danderik88/cbe-ds300-esphome-panel/firmware/images/plan_dark.png

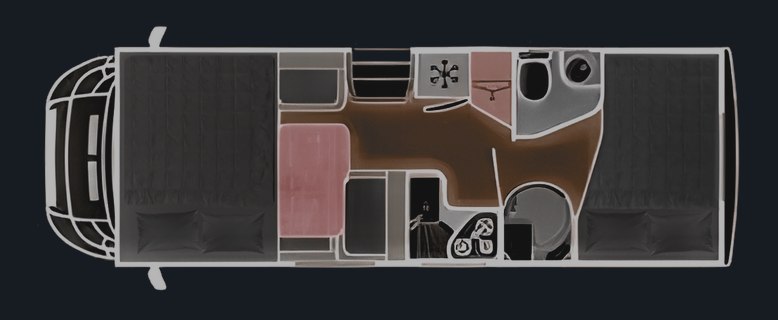
firmware/images/plan_dark.png
