danderik88/cbe-ds300-esphome-panel/firmware/images/plan_light.png

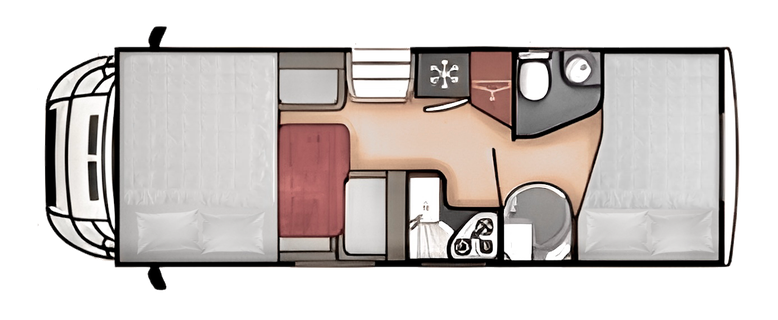
firmware/images/plan_light.png
