danderik88/cbe-ds300-esphome-panel/firmware/images/roof_top_h.png

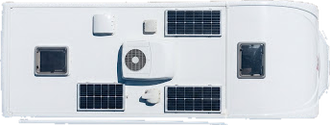
firmware/images/roof_top_h.png
