danderik88/cbe-ds300-esphome-panel/hardware/display-mount/assembly.step

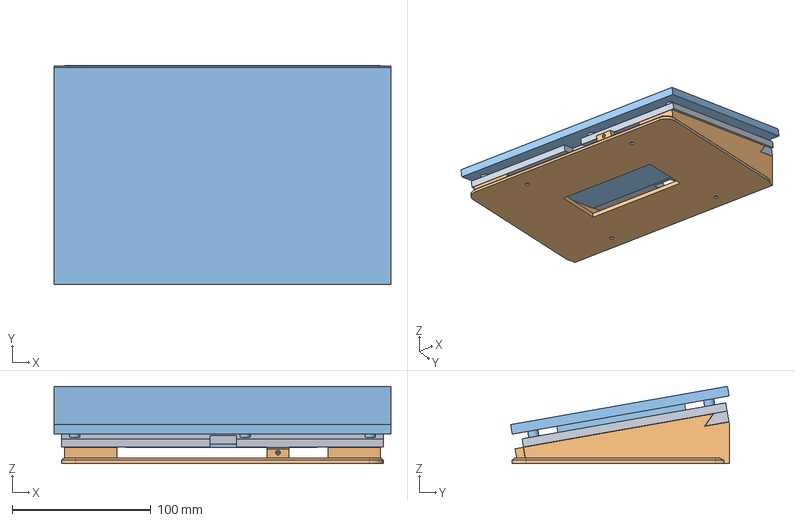
[picture p21: CAD file, 2026-10-14]
hardware/display-mount/assembly.step
242.8 x 157.7 x 55.7 mm
