danderik88/cbe-ds300-esphome-panel/hardware/display-mount/wall_bracket.step

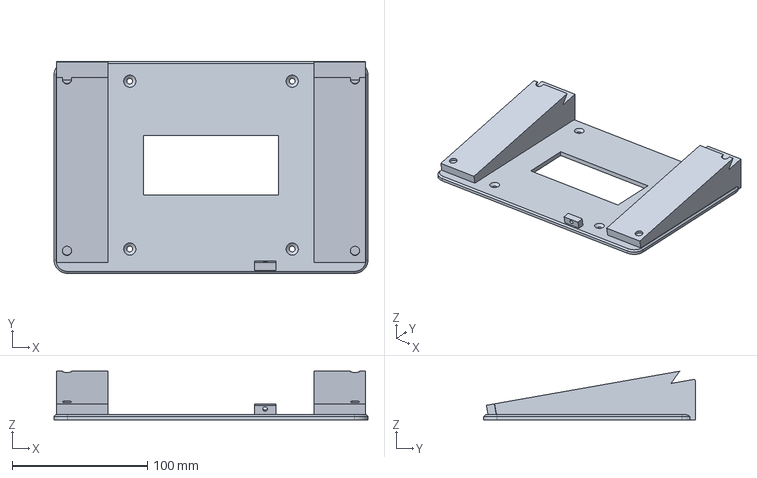
[picture p22: CAD file, 2026-10-14]
hardware/display-mount/wall_bracket.step
232.0 x 156.5 x 35.9 mm
