danderik88/cbe-ds300-esphome-panel/hardware/idc16-plug/idc16_plug.step

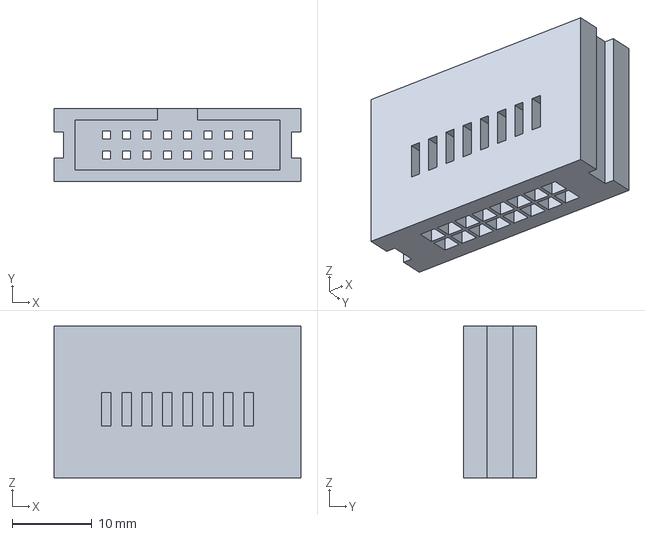
[picture p23: CAD file, 2026-10-14]
hardware/idc16-plug/idc16_plug.step
30.9 x 9.10 x 19.0 mm
