danderik88/cbe-ds300-esphome-panel/hardware/display-mount/display_plate.step

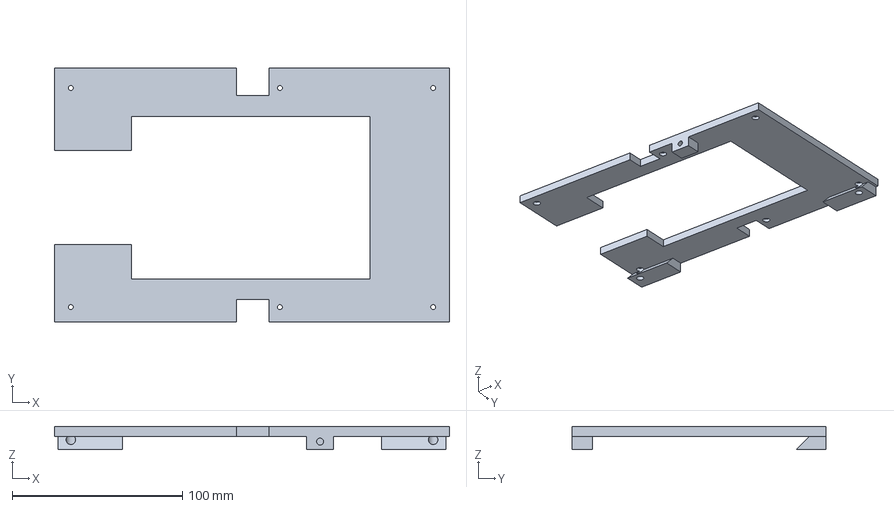
[picture p24: CAD file, 2026-10-14]
hardware/display-mount/display_plate.step
232.0 x 149.0 x 13.8 mm
