danderik88/cbe-ds300-esphome-panel/(list of files, cad)

Other CAD files:
hardware/display-mount/display_plate.stl
hardware/display-mount/wall_bracket.stl
hardware/idc16-plug/idc16_plug.stl
