danderik88/cbe-ds300-esphome-panel/firmware/panel-p4.yaml

## Dashboard camper — Guition JC8012P4A1C (ESP32-P4 + C6, 10.1" 800x1280 MIPI DSI)
##
## UI v2 (docs/ui-v2): camper panel. Fixed navigation bar
## (House, Resources, Climate, Vehicle, Media, System), true Prince layout with
## the 15 lights, autonomy estimates calculated on the panel, vehicle in
## second floor (alarms appear as banners on every page).
## Light/dark theme: switch "Dark Mode" (HA camper_monitor_dark_mode automation).
## WiFi via ESP32-C6 (esp-hosted), HA API. Audio removed (no speakers).
## Flash: see README.md.

substitutions:
  device_name: monitor-camper-p4
  device_friendly: "Monitor Camper"

  # ─── General utilities switch (conn 17 CBE pin 14 = C.GEN) ───
  # PIN required on screen before switching 12V loads.
  utenze_pin: !secret loads_pin

  # ─── CBE NTC probes on ADS1115 ───
  # Measured in camper 2026-09-28: int 12.45k @18.5 C, ext 13.58k @16.5 C.
  # Beta 3950 + R25 9.2k make both within 0.2 C. Beta not verified
  # away from 17 C: a point in water and ice (0 C) confirms it.
  ntc_beta: "3950"
  ntc_r25: "9.2kOhm"
  ntc_r_fixed: "10kOhm"

  # ─── Autonomy estimates ───
  # Ability to convert percentages: 2x100 Ah AGM, 118 L tank.
  batt_ah: "200"
  water_l: "118"
  # Greys: undocumented capacity, ~210 L by eye (2026-10-13). ponytail:
  # the full probe realigns the estimate; correct if the data is discovered.
  grey_l: "210"
  grey_from_fresh: "0.9"
  # Threshold at which battery is considered "empty" (AGM: below 40% triggers
  # critical alert in HA). Water and gas count down to 0.
  batt_floor: "40"

  # Camper Home Assistant (media player album cover)
  ha_url: !secret ha_url

esphome:
  name: ${device_name}
  friendly_name: ${device_friendly}
  min_version: 2026.1.0
  includes:
    - ui_helpers.h
  platformio_options:
    board_build.flash_mode: dio
  on_boot:
    # -100 = after setup complete: at 600 (like on the 7") the P4 crashes at boot
    # because LVGL is not yet initialized when lvgl.page.show starts
    priority: -100
    then:
      - light.turn_on: display_backlight
      - script.execute: apply_theme
      - delay: 1600ms
      - script.execute: { id: nav, idx: 0 }
      - script.execute: update_brightness
      - script.execute: update_utenze
      - script.execute: update_resources
      - script.execute: update_grey
      - script.execute: update_chart


esp32:
  variant: ESP32P4
  flash_size: 16MB
  # NB: 360MHz crashes boot on this chip (rev1.3 + engineering_sample) — see test 2026-07-04
  cpu_frequency: 400MHZ
  engineering_sample: true
  framework:
    type: esp-idf
    advanced:
      enable_idf_experimental_features: true

# WiFi via ESP32-C6 coprocessor (SDIO)
esp32_hosted:
  variant: esp32c6
  reset_pin: GPIO54
  cmd_pin: GPIO19
  clk_pin: GPIO18
  d0_pin: GPIO14
  d1_pin: GPIO15
  d2_pin: GPIO16
  d3_pin: GPIO17
  active_high: true
  sdio_frequency: 20MHz
  # use_psram REMOVED 2026-07-05: build without it stable on bench (6+ min);
  # the reference config (jtenniswood) doesn't use it. The sdio_mempool_create assert
  # on 4/7 it was a symptom of C6 not power-cycled, not the RAM.

psram:
  mode: hex
  speed: 200MHz

# MIPI DSI PHY power supply
esp_ldo:
  - channel: 3
    id: dsi_phy_enable
    voltage: 2.5V
    adjustable: true

# gsl3680 vendorized (kvj/esphome@jd9365_gsl3680 + mark_failed patch for 2026.x)
external_components:
  - source:
      type: local
      path: components
    components: [gsl3680]

logger:
  level: INFO
  # The panel's USB-C uses a UART0 bridge, not USB_SERIAL_JTAG
  hardware_uart: UART0

# Print reset reason + heap on every boot — silent crash diagnostics
debug:
  update_interval: 30s

# ────────────────────────────────────────────────────────────
# Network + Home Assistant
# ────────────────────────────────────────────────────────────
wifi:
  ssid: !secret wifi_ssid
  password: !secret wifi_password
  power_save_mode: NONE
  ap:
    ssid: "${device_name}"
    password: !secret wifi_ap_password

api:
  encryption:
    key: !secret api_key
  # Standalone: never restart if HA is absent (panel useful even without network)
  reboot_timeout: 0s

ota:
  - platform: esphome
    password: !secret ota_password

time:
  - platform: homeassistant
    id: ha_time

# ────────────────────────────────────────────────────────────
# Hardware: I2C, backlight PWM, display MIPI DSI, touch
# ────────────────────────────────────────────────────────────
i2c:
  - id: bus_i2c
    sda: GPIO7
    scl: GPIO8
    frequency: 400kHz
    scan: false
    sda_pullup_enabled: false
    scl_pullup_enabled: false

# External ADC for the two CBE NTC probes: no ADC free on P4
# free (GPIO16-23 and 49-54 are occupied or not wired on the board).
# Breakout on CN4 or FPC3, ADDR to GND -> 0x48. A2/A3 remain free.
ads1115:
  - id: adc_ntc
    i2c_id: bus_i2c
    address: 0x48
    continuous_mode: false

# I2C expander on the same CN4: controls the relay module (hardware/interface-board-bom.md).
# P0 = 1st general utilities relay. Webasto moved to dedicated ESP32 (status via HA).
# At startup outputs are high = relay at rest.
pcf8574:
  - id: exp_out
    i2c_id: bus_i2c
    address: 0x20
    pcf8575: false

# Real PWM backlight (on the 7" it was on/off + software overlay)
output:
  - platform: ledc
    id: backlight_pwm
    pin: GPIO23

light:
  - platform: monochromatic
    output: backlight_pwm
    id: display_backlight
    name: "Retroilluminazione"
    restore_mode: ALWAYS_ON
    default_transition_length: 0s
    gamma_correct: 1.0
# Symmetric wake: anything that turns on the backlight (HA, number
# brightness must also resume LVGL, otherwise screen freezes
    on_turn_on:
      - if:
          condition: lvgl.is_paused
          then:
            - lvgl.resume:
            - lvgl.widget.redraw:

display:
  - platform: mipi_dsi
    id: lcd
    model: JC8012P4A1
    color_order: RGB
    reset_pin: GPIO27
    update_interval: never
    auto_clear_enabled: false
    dimensions:
      width: 800
      height: 1280


# ────────────────────────────────────────────────────────────
# Font: Montserrat from Google Fonts (weights 500/600/700) + MDI.
# Built-in LVGL fonts don't have accented chars, so they're not used.
# ────────────────────────────────────────────────────────────
font:
  - file: "gfonts://Montserrat@700"
    id: f_t11
    size: 11
    bpp: 4
    glyphs: &txt ' !#%&''()*+,-./0123456789:;<=>?@ABCDEFGHIJKLMNOPQRSTUVWXYZ[]_abcdefghijklmnopqrstuvwxyz°·àèéìòù~'
  - file: "gfonts://Montserrat@500"
    id: f_s14
    size: 14
    bpp: 4
    glyphs: *txt
  - file: "gfonts://Montserrat@500"
    id: f_s15
    size: 15
    bpp: 4
    glyphs: *txt
  - file: "gfonts://Montserrat@700"
    id: f_h15
    size: 15
    bpp: 4
    glyphs: *txt
  - file: "gfonts://Montserrat@600"
    id: f_m17
    size: 17
    bpp: 4
    glyphs: *txt
  - file: "gfonts://Montserrat@700"
    id: f_b20
    size: 20
    bpp: 4
    glyphs: *txt
  - file: "gfonts://Montserrat@700"
    id: f_b26
    size: 26
    bpp: 4
    glyphs: *txt
  - file: "gfonts://Montserrat@700"
    id: f_b36
    size: 36
    bpp: 4
    glyphs: *txt
  - file: "gfonts://Montserrat@700"
    id: f_b48
    size: 48
    bpp: 4
    glyphs: *txt
  - file: "gfonts://Montserrat@700"
    id: f_b56
    size: 56
    bpp: 4
    glyphs: *txt
  - file: "gfonts://Montserrat@700"
    id: f_b76
    size: 76
    bpp: 4
    glyphs: "0123456789-,.°"
  # Night screen clock
  - file: "gfonts://Montserrat@700"
    id: f_b200
    size: 200
    bpp: 4
    glyphs: "0123456789:-"
  # Splash
  - file: "gfonts://Montserrat"
    id: mont_76
    size: 76
    bpp: 4
    glyphs: "montercapi"

  # ─── MDI Icons ───
  # Layout (light buttons)
  - file: "fonts/materialdesignicons-webfont.ttf"
    id: i_xs
    size: 20
    bpp: 4
    glyphs:
      - "\U000F17C9"  # wall-sconce-flat-outline (attic)
      - "\U000F179B"  # light-recessed (ceiling lights on bench)
      - "\U000F05BC"  # table-furniture
      - "\U000F0769"  # ceiling-light
      - "\U000F1051"  # led-strip-variant
      - "\U000F1054"  # outdoor-lamp
      - "\U000F04DE"  # stove
      - "\U000F0583"  # walk (hallway)
      - "\U000F09A1"  # shower-head
      - "\U000F09AB"  # toilet
      - "\U000F17D0"  # lamp-outline (nightstands)
      - "\U000F12D3"  # garage-variant (cupboard)
      - "\U000F028F"  # fridge-outline (fridge in the layout)
  # Rows, chips, card headers
  - file: "fonts/materialdesignicons-webfont.ttf"
    id: i_s
    size: 24
    bpp: 4
    glyphs:
      - "\U000F10AF"  # door-closed-lock
      - "\U000F081C"  # door-open
      - "\U000F0647"  # gas-cylinder
      - "\U000F0CC8"  # shield-check-outline
      - "\U000F0026"  # alert
      - "\U000F156D"  # sofa-outline
      - "\U000F0097"  # bunk-bed-outline
      - "\U000F0099"  # bed-outline
      - "\U000F0E50"  # lightbulb-off-outline
      - "\U000F1253"  # lightbulb-group
      - "\U000F0080"  # battery-70
      - "\U000F0084"  # battery-charging
      - "\U000F058C"  # water
      - "\U000F1855"  # water-opacity (greys)
      - "\U000F140B"  # lightning-bolt
      - "\U000F06A5"  # power-plug
      - "\U000F06A6"  # power-plug-off
      - "\U000F07E7"  # power-socket-eu (charging column)
      - "\U000F01FA"  # engine
      - "\U000F0A47"  # engine-off-outline
      - "\U000F1904"  # home-lightning-bolt-outline
      - "\U000F012A"  # chart-line
      - "\U000F0F55"  # home-thermometer-outline
      - "\U000F050F"  # thermometer
      - "\U000F0238"  # fire
      - "\U000F001B"  # air-conditioner
      - "\U000F028F"  # fridge-outline
      - "\U000F058F"  # water-pump
      - "\U000F032A"  # leaf
      - "\U000F14DF"  # rocket-launch-outline
      - "\U000F0717"  # snowflake
      - "\U000F0210"  # fan
      - "\U000F0425"  # power
      - "\U000F0C4D"  # car-tire-alert
      - "\U000F14F1"  # spirit-level
      - "\U000F08F0"  # map-marker-distance
      - "\U000F11BE"  # car-info
      - "\U000F0D5F"  # car-brake-parking
      - "\U000F0B6B"  # car-door
      - "\U000F0C4A"  # car-light-dimmed
      - "\U000F03C7"  # oil
      - "\U000F010C"  # car-battery
      - "\U000F1A80"  # thermometer-water
      - "\U000F0298"  # gas-station
      - "\U000F0469"  # router-wireless
      - "\U000F048B"  # server
      - "\U000F050E"  # theme-light-dark
      - "\U000F05E0"  # check-circle
      - "\U000F0159"  # close-circle
      - "\U000F0028"  # alert-circle
      - "\U000F11D4"  # rv-truck
      - "\U000F051F"  # timer-sand
      - "\U000F07FB"  # van-utility
      - "\U000F075A"  # music
      - "\U000F00DF"  # brightness-6
      - "\U000F0594"  # weather-night
      - "\U000F08A8"  # clipboard-check-outline
  # Navigation bar, scenes, weather, player
  - file: "fonts/materialdesignicons-webfont.ttf"
    id: i_m
    size: 32
    bpp: 4
    glyphs:
      - "\U000F02DE"  # home-variant
      - "\U000F051F"  # timer-sand
      - "\U000F0393"  # thermostat
      - "\U000F07FB"  # van-utility
      - "\U000F075A"  # music
      - "\U000F08BB"  # cog-outline
      - "\U000F0594"  # weather-night
      - "\U000F00DF"  # brightness-6
      - "\U000F059C"  # weather-sunset-up
      - "\U000F0A48"  # exit-run
      - "\U000F0A70"  # silverware-fork-knife
      - "\U000F08A8"  # clipboard-check-outline
      - "\U000F0599"  # weather-sunny
      - "\U000F0595"  # weather-partly-cloudy
      - "\U000F0590"  # weather-cloudy
      - "\U000F0597"  # weather-rainy
      - "\U000F0598"  # weather-snowy
      - "\U000F0591"  # weather-fog
      - "\U000F059D"  # weather-windy
      - "\U000F0593"  # weather-lightning
      - "\U000F0596"  # weather-pouring
      - "\U000F04AD"  # skip-next
      - "\U000F04AE"  # skip-previous
      - "\U000F075D"  # volume-plus
      - "\U000F075E"  # volume-minus
      - "\U000F040A"  # play
      - "\U000F03E4"  # pause
      - "\U000F0425"  # power
      # rest screen
      - "\U000F0F55"  # home-thermometer-outline
      - "\U000F0080"  # battery-70
      - "\U000F0CC8"  # shield-check-outline
      - "\U000F0028"  # alert-circle
  - file: "fonts/materialdesignicons-webfont.ttf"
    id: i_l
    size: 44
    bpp: 4
    glyphs:
      - "\U000F11D4"  # rv-truck (logo)
      - "\U000F051F"  # timer-sand
      - "\U000F01FA"  # engine
      - "\U000F0A47"  # engine-off-outline
      - "\U000F040A"  # play
      - "\U000F03E4"  # pause
      - "\U000F0026"  # alert
      - "\U000F0425"  # power
  - file: "fonts/materialdesignicons-webfont.ttf"
    id: i_xl
    size: 120
    bpp: 4
    glyphs:
      - "\U000F075A"  # music (player cover)

# Prince floor plan (docs/ui-v2/prince-top.png) rotated with the nose to the right and
# already composited on the card colour: one per theme, no runtime filters.
image:
  - file: images/plan_dark.png
    id: img_plan_dark
    type: RGB565
  - file: images/plan_light.png
    id: img_plan_light
    type: RGB565
  - file: images/roof_top_h.png
    id: img_roof
    type: RGB565
    transparency: alpha_channel

touchscreen:
  - platform: gsl3680
    id: touch
    i2c_id: bus_i2c
    reset_pin: GPIO22
    interrupt_pin: GPIO21
    # The GSL3680 sometimes does not raise the touch-release interrupt: without this
    # fallback the touch stays "pressed" and the next tap is swallowed
    # (double tap after a swipe). Forced re-read after 50ms of silence.
    touch_timeout: 50ms
    # Transform for landscape with lvgl rotation: 90 (from espcontrol, same board)
    transform:
      swap_xy: false
      mirror_x: true
      mirror_y: false
    # Touch-to-wake (replaces the touch_any binary_sensor of the 7")
    on_release:
      then:
        - if:
            condition:
              lvgl.is_paused
            then:
              # Turns on at the current brightness (the global may have been
              # changed by the HA automation while the screen was off)
              - light.turn_on:
                  id: display_backlight
                  brightness: !lambda 'return id(display_brightness) / 100.0;'
              - lvgl.resume:
              - lvgl.widget.redraw:
              # Turned off from the clock screen: go back to House
              - if:
                  condition:
                    lambda: 'return id(night_on);'
                  then:
                    - script.execute: night_exit

# ────────────────────────────────────────────────────────────
# ESP32 diagnostics
# ────────────────────────────────────────────────────────────
button:
  - platform: restart
    name: "Riavvia"
    icon: "mdi:restart"

  - platform: safe_mode
    name: "Safe Mode"
    icon: "mdi:shield-bug"

  # Below 10V the DS-300 cuts the loads and only re-arms with OFF->ON
  # of the main switch (CBE manual p. 6).
  - platform: template
    name: "Reset utenze 12V"
    icon: "mdi:restart-alert"
    on_press:
      - switch.turn_off: sw_utenze
      - delay: 3s
      - switch.turn_on: sw_utenze

# ────────────────────────────────────────────────────────────
# Album cover (Media page): HA exposes the media player cover as
# entity_picture (token proxy, no login). The panel downloads it
# from HA on every change and shows it instead of the music note.
# ────────────────────────────────────────────────────────────
http_request:
  timeout: 10s

online_image:
  - id: cover_img
    url: "${ha_url}/local/cover.jpg"  # replaced by set_url, never downloaded on its own
    # Covers from the Apple TV (HomePod) integration arrive as JPEG
    format: JPEG
    type: RGB565
    resize: 400x400
    buffer_size: 32768
    on_download_finished:
      - lvgl.image.update: { id: md_cover, src: cover_img }
      - lvgl.widget.show: md_cover
    on_error:
      - lvgl.widget.hide: md_cover


# ────────────────────────────────────────────────────────────
# ESP32 diagnostics
# ────────────────────────────────────────────────────────────
sensor:
  - platform: wifi_signal
    name: "WiFi Segnale"
    update_interval: 30s
    entity_category: diagnostic

  - platform: uptime
    name: "Uptime"
    entity_category: diagnostic

  - platform: internal_temperature
    name: "Temperatura CPU"
    entity_category: diagnostic
    update_interval: 60s

  # ────────────────────────────────────────────────────────────
  # CBE temperature probes (2-wire NTC) on ADS1115
  # Divider: 3V3 -> fixed R 10k 1% -> ADS channel -> NTC -> GND
  # A0 = INDOOR probe, A1 = OUTDOOR probe
  # ────────────────────────────────────────────────────────────
  - platform: ads1115
    ads1115_id: adc_ntc
    id: ntc_int_v
    multiplexer: A0_GND
    gain: 4.096
    update_interval: 10s
    internal: true
    filters:
      - median:
          window_size: 5
          send_every: 3

  - platform: resistance
    id: ntc_int_r
    sensor: ntc_int_v
    configuration: DOWNSTREAM
    resistor: ${ntc_r_fixed}
    reference_voltage: 3.3V
    internal: true

  - platform: ntc
    id: temp_int_ntc
    sensor: ntc_int_r
    name: "Temp interna (sonda CBE)"
    unit_of_measurement: "°C"
    accuracy_decimals: 1
    calibration:
      b_constant: ${ntc_beta}
      reference_temperature: 25°C
      reference_resistance: ${ntc_r25}
    filters:
      # Probe disconnected / shorted -> absurd value: don't show it
      - filter_out: nan
      - lambda: 'return (x > -40.0f && x < 90.0f) ? x : NAN;'
    on_value:
      - lambda: 'id(ntc_int_seen) = millis();'
      - script.execute: update_temps

  # Grey tank full probe: 3V3 -> 100k -> A2 -> electrode; common = pin 11 (AGND).
  # Dry ~3.3 V, wet below ~1.6 V. The tank only has the full-level pair
  # (blue/brown screws at the top, validated with a jumper 2026-10-13); REC 1/3 (A3)
  # follows the full probe upstream in the DS-300, so it is not read.
  - platform: ads1115
    ads1115_id: adc_ntc
    id: grey_full_v
    name: "Grigie pieno (tensione sonda)"
    multiplexer: A2_GND
    gain: 4.096
    update_interval: 10s
    accuracy_decimals: 2

  - platform: ads1115
    ads1115_id: adc_ntc
    id: ntc_ext_v
    multiplexer: A1_GND
    gain: 4.096
    update_interval: 10s
    internal: true
    filters:
      - median:
          window_size: 5
          send_every: 3

  - platform: resistance
    id: ntc_ext_r
    sensor: ntc_ext_v
    configuration: DOWNSTREAM
    resistor: ${ntc_r_fixed}
    reference_voltage: 3.3V
    internal: true

  - platform: ntc
    id: temp_ext_ntc
    sensor: ntc_ext_r
    name: "Temp esterna (sonda CBE)"
    unit_of_measurement: "°C"
    accuracy_decimals: 1
    calibration:
      b_constant: ${ntc_beta}
      reference_temperature: 25°C
      reference_resistance: ${ntc_r25}
    filters:
      - filter_out: nan
      - lambda: 'return (x > -40.0f && x < 90.0f) ? x : NAN;'
    on_value:
      - lambda: 'id(ntc_ext_seen) = millis();'
      - script.execute: update_temps

  # ─── Energy (Victron SmartShunt) ───
  - platform: homeassistant
    id: ha_batt_soc
    entity_id: sensor.victron_smart_shunt_battery
    on_value:
      - script.execute: update_resources
  - platform: homeassistant
    id: ha_current
    entity_id: sensor.victron_smart_shunt_current
    on_value:
      - script.execute: update_resources
  - platform: homeassistant
    id: ha_batt_v2
    entity_id: sensor.victron_smart_shunt_voltage
    on_value:
      - lvgl.label.update:
          id: rs_batt_u
          text: !lambda 'return ui::fmt(x, 1, " V");'
  - platform: homeassistant
    id: ha_batt_v1
    entity_id: sensor.victron_smart_shunt_starter_battery_voltage
    on_value:
      - lvgl.label.update:
          id: vs_v1
          text: !lambda 'return ui::fmt(x, 1, " V");'
  - platform: homeassistant
    id: ha_batt_power
    entity_id: sensor.victron_smart_shunt_power
    on_value:
      - lvgl.label.update:
          id: rc_pow
          text: !lambda 'return ui::fmt(x, 0, " W");'

  # ─── 230V mains from the hookup post (Sonoff MINI-ZB1GP; unavailable = post unplugged) ───
  - platform: homeassistant
    id: ha_rete_w
    entity_id: sensor.rete_230v_power
    on_value: { script.execute: update_rete }
  - platform: homeassistant
    id: ha_rete_a
    entity_id: sensor.rete_230v_current
    on_value: { script.execute: update_rete }
  - platform: homeassistant
    id: ha_rete_lim
    entity_id: input_number.limite_colonnina
    on_value: { script.execute: update_rete }

  # ─── Water and gas ───
  - platform: homeassistant
    id: ha_water
    entity_id: sensor.esp32_serbatoio_acqua_livello_acqua
    on_value:
      - script.execute: update_resources
      # Greys: count only fresh water drops; hysteresis against level noise
      # (noise counted only on the way down would make the estimate creep up by itself).
      - lambda: |-
          float &ref = id(fresh_ref);
          if (isnan(x)) return;
          if (isnan(ref) || x > ref + 3.0f) { ref = x; return; }  // start or refill
          if (x < ref - 1.0f) {
            id(grey_est_l) = std::min(id(grey_est_l) + (ref - x) / 100.0f * ${water_l} * ${grey_from_fresh}f, (float) ${grey_l});
            ref = x;
            id(update_grey).execute();
          }
  # LPG cylinder by weight (esp32-panca: 4 load cells + HX711)
  - platform: homeassistant
    id: ha_gas_percent
    entity_id: sensor.panca_gas_remaining_percent
    on_value:
      - script.execute: update_resources
  - platform: homeassistant
    id: ha_gas_kg
    entity_id: sensor.panca_gas_remaining
    on_value:
      - lvgl.label.update:
          id: rs_gas_u
          text: !lambda 'return ui::fmt(x, 1, " kg");'

  # ─── Room temperatures ───
  - platform: homeassistant
    id: ha_t_din
    entity_id: sensor.sensore_presenza_dinette_temperature
    on_value:
      - script.execute: update_temps
  - platform: homeassistant
    id: ha_h_din
    entity_id: sensor.sensore_presenza_dinette_humidity
    on_value:
      - lvgl.label.update:
          id: dentro_ur
          text: !lambda 'return ui::fmt(x, 0, "%");'
  - platform: homeassistant
    id: ha_t_mans
    entity_id: sensor.termoigrometro_mansarda_temperature
    on_value:
      - script.execute: update_temps
  - platform: homeassistant
    id: ha_t_letto
    entity_id: sensor.termoigrometro_camera_da_letto_temperature
    on_value:
      - script.execute: update_temps
  - platform: homeassistant
    id: ha_t_frigo_int
    entity_id: sensor.termoigrometro_frigorifero_temperature
    on_value:
      - lambda: |-
          if (isnan(x)) return;
          if (x < 10.0f) { id(dom_on) = true; id(dom_warm_since) = 0; }
          else if (id(dom_on) && id(dom_warm_since) == 0) id(dom_warm_since) = millis();
          ui::checked(id(fr_dom), id(dom_on));
      - lvgl.label.update:
          id: am_frigo
          text: !lambda 'return ui::fmt(x, 1, "°");'
  # Fallback for the CBE outdoor probe
  - platform: homeassistant
    id: ha_temp_ext
    entity_id: sensor.bthome_sensor_bbf7_temperatura
    on_value:
      - script.execute: update_temps
  - platform: homeassistant
    id: ha_weather_temp
    entity_id: weather.forecast_casa
    attribute: temperature
    internal: true

  # ─── Vevor fridge ───
  - platform: homeassistant
    id: ha_frigo_temp
    entity_id: climate.vevor_c50_fridge
    attribute: current_temperature
    on_value:
      - script.execute: update_clima
  - platform: homeassistant
    id: ha_frigo_target
    entity_id: climate.vevor_c50_fridge
    attribute: temperature
    on_value:
      - lambda: 'if (!isnan(x)) id(frigo_target) = x;'
      - script.execute: update_clima

  # ─── Air conditioner (generic_thermostat, only with 230V) ───
  - platform: homeassistant
    id: ha_clima_now
    entity_id: climate.climatizzatore_camper
    attribute: current_temperature
    on_value:
      - script.execute: update_clima
  - platform: homeassistant
    id: ha_clima_target
    entity_id: climate.climatizzatore_camper
    attribute: temperature
    on_value:
      - lambda: 'if (!isnan(x)) id(clima_target) = x;'
      - script.execute: update_clima

  # ─── Vehicle (WiCAN / Torque) ───
  - platform: homeassistant
    id: ha_fuel
    entity_id: sensor.livello_carburante_camper
    on_value:
      - script.execute: update_vehicle
  - platform: homeassistant
    id: ha_fuel_km
    entity_id: sensor.autonomia_carburante_camper
    on_value:
      - script.execute: update_vehicle
  - platform: homeassistant
    id: ha_km_tot
    entity_id: sensor.wican_km_totali
    on_value:
      - lvgl.label.update:
          id: vs_km
          text: !lambda |-
            if (isnan(x)) return std::string("--");
            char b[16]; snprintf(b, sizeof b, "%.0f", x);
            std::string s(b);   // thousand separator (Italian style)
            for (int i = (int) s.size() - 3; i > 0; i -= 3) s.insert(i, ".");
            return s;
  - platform: homeassistant
    id: ha_oil
    entity_id: sensor.temperatura_olio_motore
    on_value:
      - script.execute: update_vehicle
  - platform: homeassistant
    id: ha_coolant
    entity_id: sensor.temperatura_liquido_raffreddamento
    on_value:
      - script.execute: update_vehicle
  - platform: homeassistant
    id: ha_trip_km
    entity_id: sensor.wican_distanza_viaggio
    on_value:
      - lvgl.label.update:
          id: tr_dist
          text: !lambda 'return ui::fmt(x, 0, " km");'
  - platform: homeassistant
    id: ha_trip_h
    entity_id: sensor.wican_durata_viaggio
    on_value:
      - lvgl.label.update:
          id: tr_dur
          text: !lambda |-
            if (isnan(x)) return std::string("--");
            int m = (int) lroundf(x * 60);
            char b[16]; snprintf(b, sizeof b, "%d h %02d", m / 60, m % 60); return std::string(b);
  - platform: homeassistant
    id: ha_trip_avg
    entity_id: sensor.wican_velocita_media
    on_value:
      - lvgl.label.update:
          id: tr_avg
          text: !lambda 'return ui::fmt(x, 0, " km/h");'
  - platform: homeassistant
    id: ha_trip_cons
    entity_id: sensor.wican_consumo_medio
    on_value:
      - lvgl.label.update:
          id: tr_cons
          text: !lambda 'return ui::fmt(x, 1, " L");'
  # Tyres (TPMS) + thresholds adjustable from the Atoto Tyres view
  - platform: homeassistant
    id: ha_p_as
    entity_id: sensor.pressione_anteriore_sinistra
    on_value: { script.execute: update_tyres }
  - platform: homeassistant
    id: ha_p_ad
    entity_id: sensor.pressione_anteriore_destra
    on_value: { script.execute: update_tyres }
  - platform: homeassistant
    id: ha_p_ps
    entity_id: sensor.pressione_posteriore_sinistra
    on_value: { script.execute: update_tyres }
  - platform: homeassistant
    id: ha_p_pd
    entity_id: sensor.pressione_posteriore_destra
    on_value: { script.execute: update_tyres }
  - platform: homeassistant
    id: ha_tt_as
    entity_id: sensor.temperatura_gomma_anteriore_sinistra
    on_value: { script.execute: update_tyres }
  - platform: homeassistant
    id: ha_tt_ad
    entity_id: sensor.temperatura_gomma_anteriore_destra
    on_value: { script.execute: update_tyres }
  - platform: homeassistant
    id: ha_tt_ps
    entity_id: sensor.temperatura_gomma_posteriore_sinistra
    on_value: { script.execute: update_tyres }
  - platform: homeassistant
    id: ha_tt_pd
    entity_id: sensor.temperatura_gomma_posteriore_destra
    on_value: { script.execute: update_tyres }
  - platform: homeassistant
    id: ha_tpms_min_ant
    entity_id: input_number.tpms_anteriore_minima
    internal: true
  - platform: homeassistant
    id: ha_tpms_min_post
    entity_id: input_number.tpms_posteriore_minima
    internal: true
  - platform: homeassistant
    id: ha_tpms_max_ant
    entity_id: input_number.tpms_anteriore_massima
    internal: true
  - platform: homeassistant
    id: ha_tpms_max_post
    entity_id: input_number.tpms_posteriore_massima
    internal: true
  # Level (5 s moving average in HA)
  - platform: homeassistant
    id: ha_tilt_x
    entity_id: sensor.inclinazione_camper_x_filtrata
    on_value: { script.execute: update_level }
  - platform: homeassistant
    id: ha_tilt_y
    entity_id: sensor.inclinazione_camper_y_filtrata
    on_value: { script.execute: update_level }

  # ─── System: GL.iNet router and HAOS host ───
  - platform: homeassistant
    id: ha_router_mem
    entity_id: sensor.gl_inet_x750_memory_usage
    on_value:
      - lvgl.label.update: { id: rtr_mem, text: !lambda 'return ui::fmt(x, 0, "%");' }
  - platform: homeassistant
    id: ha_router_load
    entity_id: sensor.gl_inet_x750_load_avg_1m
    on_value:
      - lvgl.label.update: { id: rtr_load, text: !lambda 'return ui::fmt(x, 2);' }
  - platform: homeassistant
    id: ha_router_clients
    entity_id: sensor.router_client_connessi
    on_value:
      - lvgl.label.update: { id: rtr_clients, text: !lambda 'return ui::fmt(x, 0);' }
  - platform: homeassistant
    id: ha_router_signal
    entity_id: sensor.router_wifi_segnale
    on_value:
      - lvgl.label.update: { id: rtr_signal, text: !lambda 'return ui::fmt(x, 0, " dBm");' }
  - platform: homeassistant
    id: ha_host_cpu
    entity_id: sensor.system_monitor_processor_use
    on_value:
      - lvgl.label.update: { id: host_cpu, text: !lambda 'return ui::fmt(x, 0, "%");' }
  - platform: homeassistant
    id: ha_host_mem
    entity_id: sensor.system_monitor_memory_usage
    on_value:
      - lvgl.label.update: { id: host_mem, text: !lambda 'return ui::fmt(x, 0, "%");' }
  - platform: homeassistant
    id: ha_host_disk
    entity_id: sensor.system_monitor_disk_usage
    on_value:
      - lvgl.label.update: { id: host_disk, text: !lambda 'return ui::fmt(x, 0, "%");' }

text_sensor:
  - platform: wifi_info
    ip_address:
      id: wifi_ip
      name: "IP Address"
      icon: "mdi:ip-network"
      entity_category: diagnostic
    ssid:
      name: "WiFi SSID"
      entity_category: diagnostic
    mac_address:
      name: "MAC Address"
      entity_category: diagnostic

  # ─── Weather, media ───
  - platform: homeassistant
    id: ha_weather_state
    entity_id: weather.forecast_casa
    on_value:
      - script.execute: update_temps
  - platform: homeassistant
    id: ha_media_title
    entity_id: media_player.homepod_mini
    attribute: media_title
    on_value:
      - script.execute: update_nt_track
      - lvgl.label.update: { id: md_title, text: !lambda 'return x.empty() ? std::string("Niente in riproduzione") : x;' }
  - platform: homeassistant
    id: ha_media_artist
    entity_id: media_player.homepod_mini
    attribute: media_artist
    on_value:
      - script.execute: update_nt_track
      - lvgl.label.update: { id: md_artist, text: !lambda 'return x;' }
  - platform: homeassistant
    id: ha_media_pic
    entity_id: media_player.homepod_mini
    attribute: entity_picture
    on_value:
      - lambda: 'id(cover_url) = (x.empty() || x == "None") ? std::string() : x;'
      - script.execute: load_cover
  - platform: homeassistant
    id: ha_media_state
    entity_id: media_player.homepod_mini
    on_value:
      - script.execute: update_nt_track
      - lvgl.label.update:
          id: md_play_ico
          text: !lambda 'return std::string(x == "playing" ? "\U000F03E4" : "\U000F040A");'
      - lvgl.label.update:
          id: md_state
          text: !lambda |-
            if (x == "playing") return std::string("In riproduzione · HomePod Dinette");
            if (x == "paused") return std::string("In pausa · HomePod Dinette");
            if (x == "unavailable") return std::string("HomePod non raggiungibile");
            return std::string("HomePod Dinette");

  # ─── Fridge and air conditioner ───
  - platform: homeassistant
    id: ha_frigo_state
    entity_id: climate.vevor_c50_fridge
    on_value: { script.execute: update_clima }
  - platform: homeassistant
    id: ha_frigo_preset
    entity_id: climate.vevor_c50_fridge
    attribute: preset_mode
    on_value: { script.execute: update_clima }
  - platform: homeassistant
    id: ha_clima_state
    entity_id: climate.climatizzatore_camper
    on_value: { script.execute: update_clima }
  # the IR switch itself: on without the thermostat = manual cooling
  - platform: homeassistant
    id: ha_clima_sw
    entity_id: switch.climatizzatore
    on_value: { script.execute: update_clima }
  # on = 230V present and Broadlink reachable
  - platform: homeassistant
    id: ha_clima_ok
    entity_id: binary_sensor.clima_disponibile
    on_value: { script.execute: update_clima }

  # ─── Energy: charging source and charger state ───
  - platform: homeassistant
    id: ha_charge_src
    entity_id: sensor.sorgente_carica
    on_value:
      - lvgl.label.update: { id: rc_src, text: !lambda 'return x;' }
  - platform: homeassistant
    id: ha_charger_mode
    entity_id: sensor.caricabatterie_modo
    on_value:
      - lvgl.label.update: { id: rc_mode, text: !lambda 'return x == "unavailable" || x == "unknown" ? std::string("spento") : x;' }
  # on = hookup post present but nothing reaches the camper (HA template, delay_on 1 min)
  - platform: homeassistant
    id: ha_rete_mt
    entity_id: binary_sensor.magnetotermico_230v_scattato
    on_value: { script.execute: update_rete }

  # ─── Living area security ───
  - platform: homeassistant
    id: ha_porta
    entity_id: binary_sensor.sensore_porta_entrata_contact
    on_value: { script.execute: update_security }
  - platform: homeassistant
    id: ha_gas_alarm
    entity_id: binary_sensor.esp32_cucina_allarme_gas
    on_value: { script.execute: update_security }
  - platform: homeassistant
    id: ha_pompa
    entity_id: switch.esp32_serbatoio_acqua_pompa
    on_value:
      - lvgl.label.update:
          id: st_pompa_v
          text: !lambda 'return x == "on" ? std::string("ON") : (x == "off" ? std::string("OFF") : std::string("--"));'
          text_color: !lambda 'return x == "on" ? lv_color_hex(0x34C759) : lv_color_hex(0x8A909A);'
      - lvgl.label.update:
          id: rs_acq_k2
          text: !lambda 'return x == "on" ? std::string("ON") : (x == "off" ? std::string("OFF") : std::string("--"));'

  # ─── Vehicle: CAN states ───
  - platform: homeassistant
    id: ha_motore
    entity_id: binary_sensor.wican_motore_acceso
    on_value: { script.execute: update_vehicle }
  - platform: homeassistant
    id: ha_freno
    entity_id: binary_sensor.wican_freno_a_mano
    on_value: { script.execute: update_vehicle }
  - platform: homeassistant
    id: ha_porte_cab
    entity_id: binary_sensor.wican_porte
    on_value: { script.execute: update_vehicle }
  - platform: homeassistant
    id: ha_anabb
    entity_id: binary_sensor.wican_anabbaglianti
    on_value: { script.execute: update_vehicle }
  - platform: homeassistant
    id: ha_livella
    entity_id: sensor.livella_status
    on_value: { script.execute: update_level }

  # ─── Lights: state of the 15 lights (names and positions as on the Atoto) ───
  - platform: homeassistant
    id: ha_l_princ
    entity_id: light.kincony_kc868_a16_luce_1
    on_value:
      - lvgl.widget.update: { id: lt_princ, state: { checked: !lambda 'return x == "on";' } }
      - script.execute: update_lights
  - platform: homeassistant
    id: ha_l_tavolo
    entity_id: light.shellyplus1_441793a44110_switch_0
    on_value:
      - lvgl.widget.update: { id: lt_tavolo, state: { checked: !lambda 'return x == "on";' } }
      - script.execute: update_lights
  - platform: homeassistant
    id: ha_l_panca
    entity_id: light.faretti_panca
    on_value:
      - lvgl.widget.update: { id: lt_panca, state: { checked: !lambda 'return x == "on";' } }
      - script.execute: update_lights
  - platform: homeassistant
    id: ha_l_leddin
    entity_id: light.kincony_kc868_a16_luce_9
    on_value:
      - lvgl.widget.update: { id: lt_leddin, state: { checked: !lambda 'return x == "on";' } }
      - script.execute: update_lights
  - platform: homeassistant
    id: ha_l_corr
    entity_id: light.kincony_kc868_a16_luce_2
    on_value:
      - lvgl.widget.update: { id: lt_corr, state: { checked: !lambda 'return x == "on";' } }
      - script.execute: update_lights
  - platform: homeassistant
    id: ha_l_cucina
    entity_id: light.kincony_kc868_a16_luce_3
    on_value:
      - lvgl.widget.update: { id: lt_cucina, state: { checked: !lambda 'return x == "on";' } }
      - script.execute: update_lights
  - platform: homeassistant
    id: ha_l_ledcuc
    entity_id: light.esp32_cucina_led_switch
    on_value:
      - lvgl.widget.update: { id: lt_ledcuc, state: { checked: !lambda 'return x == "on";' } }
      - script.execute: update_lights
  - platform: homeassistant
    id: ha_l_bagno
    entity_id: light.kincony_kc868_a16_luce_4
    on_value:
      - lvgl.widget.update: { id: lt_bagno, state: { checked: !lambda 'return x == "on";' } }
      - script.execute: update_lights
  - platform: homeassistant
    id: ha_l_doccia
    entity_id: light.shelly1_34945479f8e1
    on_value:
      - lvgl.widget.update: { id: lt_doccia, state: { checked: !lambda 'return x == "on";' } }
      - script.execute: update_lights
  - platform: homeassistant
    id: ha_l_gavone
    entity_id: light.shellyplus1_d0ef76d9cac0_switch_0
    on_value:
      - lvgl.widget.update: { id: lt_gavone, state: { checked: !lambda 'return x == "on";' } }
      - script.execute: update_lights
  - platform: homeassistant
    id: ha_l_esterna
    entity_id: light.kincony_kc868_a16_luce_12
    on_value:
      - lvgl.widget.update: { id: lt_esterna, state: { checked: !lambda 'return x == "on";' } }
      - script.execute: update_lights
  - platform: homeassistant
    id: ha_l_mans1
    entity_id: light.esp32_mansarda_luce_1
    on_value:
      - lvgl.widget.update: { id: lt_mans1, state: { checked: !lambda 'return x == "on";' } }
      - script.execute: update_lights
  - platform: homeassistant
    id: ha_l_mans2
    entity_id: light.esp32_mansarda_luce_2
    on_value:
      - lvgl.widget.update: { id: lt_mans2, state: { checked: !lambda 'return x == "on";' } }
      - script.execute: update_lights
  - platform: homeassistant
    id: ha_l_letto1
    entity_id: light.esp32_letto_luce_letto_1
    on_value:
      - lvgl.widget.update: { id: lt_letto1, state: { checked: !lambda 'return x == "on";' } }
      - script.execute: update_lights
  - platform: homeassistant
    id: ha_l_letto2
    entity_id: light.esp32_letto_luce_letto_2
    on_value:
      - lvgl.widget.update: { id: lt_letto2, state: { checked: !lambda 'return x == "on";' } }
      - script.execute: update_lights

globals:
  # Seconds until the loads are cut during spegni_server (countdown)
  - id: ut_left
    type: int
    initial_value: '0'
  # Estimated greys: fresh litres used x${grey_from_fresh} since the last emptying
  - id: grey_est_l
    type: float
    restore_value: yes
    initial_value: '0'
  - id: fresh_ref
    type: float
    restore_value: no
    initial_value: 'NAN'
  - id: dark_mode
    type: bool
    restore_value: yes
    initial_value: 'true'
  - id: display_brightness
    type: int
    restore_value: yes
    initial_value: '100'
  # Current setpoints (mirrored from HA, for the -/+ buttons)
  - id: clima_target
    type: float
    restore_value: no
    initial_value: '25.0'
  - id: frigo_target
    type: float
    restore_value: no
    initial_value: '4.0'
  # Domotic fridge (not smart): on if the inside drops below 10°,
  # off after 30 consecutive min above
  - id: dom_on
    type: bool
    restore_value: no
    initial_value: 'false'
  - id: dom_warm_since
    type: uint32_t
    restore_value: no
    initial_value: '0'
  # Rest start (millis): within 10 s a touch returns to the previous page
  - id: night_t
    type: uint32_t
    initial_value: '0'
  # Active page: 0 House, 1 Resources, 2 Climate, 3 Vehicle, 4 Media, 5 System
  - id: cur_page
    type: int
    restore_value: no
    initial_value: '0'
  # Night screen active: no automatic backlight off
  - id: night_on
    type: bool
    restore_value: no
    initial_value: 'false'
  # millis() of the last valid reading of the local NTCs (0 = never read)
  - id: ntc_int_seen
    type: uint32_t
    restore_value: no
    initial_value: '0'
  - id: ntc_ext_seen
    type: uint32_t
    restore_value: no
    initial_value: '0'
  # Loads PIN keypad
  - id: pin_buf
    type: std::string
    restore_value: no
    initial_value: '""'
  - id: pin_target
    type: bool
    restore_value: no
    initial_value: 'false'
  # Alarm banner: current text and already-seen text ("Ok, visto")
  - id: alarm_text
    type: std::string
    restore_value: no
    initial_value: '""'
  - id: alarm_seen
    type: std::string
    restore_value: no
    initial_value: '""'
  - id: alarm_idx
    type: int
    restore_value: no
    initial_value: '0'
  # Hourly resource history (72 h, % 0-100, 255 = no data).
  # Saved in flash: written once an hour, estimates survive reboots.
  - id: hist_batt
    type: std::array<uint8_t, 72>
    restore_value: yes
  - id: hist_water
    type: std::array<uint8_t, 72>
    restore_value: yes
  - id: hist_gas
    type: std::array<uint8_t, 72>
    restore_value: yes
  # Album cover: current URL (entity_picture) and last downloaded
  - id: cover_url
    type: std::string
    restore_value: no
    initial_value: '""'
  - id: cover_loaded
    type: std::string
    restore_value: no
    initial_value: '""'
  - id: hist_head
    type: int
    restore_value: yes
    initial_value: '0'
  # Hour (epoch/3600) of the last sample; 0 = history never initialized
  - id: hist_hour
    type: uint32_t
    restore_value: yes
    initial_value: '0'

# Dark mode exposed to HA: toggled by the camper_monitor_dark_mode automation (lux)
switch:
  - platform: template
    id: sw_dark_mode
    name: "Dark Mode"
    icon: "mdi:theme-light-dark"
    lambda: 'return id(dark_mode);'
    turn_on_action:
      - globals.set: { id: dark_mode, value: 'true' }
      - script.execute: apply_theme
    turn_off_action:
      - globals.set: { id: dark_mode, value: 'false' }
      - script.execute: apply_theme

  # ────────────────────────────────────────────────────────────
  # Main loads switch — CBE conn 17, pin 14 (C.GEN), level-driven
  # (verified 2026-08-13: pin 14 to GND = loads on).
  # PCF8574 P0 -> IN1 of the relay module (low level trigger). On 2026-10-13 the
  # relay did not click because of a broken white Dupont, not the pin. Relay 1: COM -> pin 3,
  # NC -> pin 14. P0 high = relay at rest = NC closed = loads ON, so
  # no inversion. Panel off/faulty = loads on.
  # The HAOS Raspberry and the GL.iNet are on the loads line too: switch off
  # only through the spegni_server script.
  - platform: gpio
    id: sw_utenze
    name: "Utenze 12V"
    icon: "mdi:power"
    pin:
      pcf8574: exp_out
      number: 0
      mode:
        output: true
    # The camper must come back ON after a panel reboot
    restore_mode: RESTORE_DEFAULT_ON

  # Water pump — PCF8574 P1 -> IN2, relay 2: COM -> conn17 pin 3 (GND),
  # NC -> pin 6 (C.POMPA), instead of the fixed jumper. P1 high = NC closed =
  # pump powered. For maintenance or leaks in the tank bay. The tank ESP
  # is on the same line: with the pump off, it goes offline too.
  - platform: gpio
    id: sw_pompa
    name: "Pompa acqua"
    icon: "mdi:water-pump"
    pin:
      pcf8574: exp_out
      number: 1
      mode:
        output: true
    # On every boot the pump comes back powered
    restore_mode: ALWAYS_ON


number:
  - platform: template
    id: num_brightness
    name: "Luminosita Display"
    icon: "mdi:brightness-6"
    min_value: 30
    max_value: 100
    step: 5
    lambda: 'return id(display_brightness);'
    update_interval: 5s
    set_action:
      - globals.set:
          id: display_brightness
          value: !lambda 'return (int)x;'
      - script.execute: update_brightness


# ────────────────────────────────────────────────────────────
# LVGL — UI v2 (docs/ui-v2)
# Screen coordinates 1280x800: navigation bar 0-104, content
# x 124-1260, top bar y 16-80, content y 96-784.
# Colours: ALL in the styles below (dark theme values); apply_theme
# rewrites them for the light theme. Widgets set no inline theme colours,
# only semantic ones (green/amber/red/blue/orange), same in both themes.
# ────────────────────────────────────────────────────────────
lvgl:
  id: lvgl_comp
  displays: [lcd]
  touchscreens: [touch]
  # Native 800x1280 portrait panel -> 1280x800 landscape UI
  rotation: 90
  byte_order: little_endian
  buffer_size: 25%
  log_level: WARN
  text_font: f_m17

  style_definitions:
    - { id: st_page, bg_color: 0x0E1116, bg_opa: COVER, text_color: 0xF2F2F4 }
    - { id: st_card, bg_color: 0x171B22, bg_opa: COVER, radius: 24, border_width: 0, pad_all: 0, shadow_width: 0 }
    - { id: st_tile, bg_color: 0x20252E, bg_opa: COVER, radius: 16, border_width: 0, pad_all: 0, shadow_width: 0, text_color: 0xF2F2F4 }
    - { id: st_light, bg_color: 0x20252E, bg_opa: COVER, border_width: 2, border_color: 0x262C36, pad_all: 0, shadow_width: 0, text_color: 0x8A909A }
    - { id: st_cold, bg_color: 0x16283A, bg_opa: COVER, border_color: 0x5AA9E6, text_color: 0x9FD0F5, shadow_color: 0x5AA9E6, shadow_width: 26, shadow_opa: 45%, shadow_spread: 1 }
    - { id: st_on, bg_color: 0x3A2A1E, bg_opa: COVER, border_color: 0xF5B461, text_color: 0xFFD9B0, shadow_color: 0xF5B461, shadow_width: 26, shadow_opa: 45%, shadow_spread: 1 }
    - { id: st_txt, text_color: 0xF2F2F4 }
    - { id: st_mut, text_color: 0x8A909A }
    - { id: st_dim, text_color: 0x5A606A }
    - { id: st_sep, bg_color: 0x262C36, bg_opa: COVER, radius: 0, border_width: 0, pad_all: 0 }
    - { id: st_track, bg_color: 0x20252E, bg_opa: COVER }
    - { id: st_arctrack, arc_color: 0x20252E, arc_width: 24, bg_opa: TRANSP, border_width: 0, pad_all: 0 }
    - { id: st_ring, bg_opa: TRANSP, border_width: 2, border_color: 0x262C36, pad_all: 0 }
    - { id: st_rail, bg_opa: TRANSP, radius: 20, border_width: 0, shadow_width: 0, pad_all: 0, text_color: 0x8A909A }
    - { id: st_railon, bg_color: 0x20252E, bg_opa: COVER, text_color: 0xE8845C }
    - { id: st_railbox, bg_opa: TRANSP, radius: 0, pad_all: 0, border_width: 1, border_side: RIGHT, border_color: 0x262C36 }
    - { id: st_banner, bg_color: 0x5A1612, bg_opa: COVER, radius: 18, border_width: 0, pad_all: 0, text_color: 0xFFD4CF }
    - { id: st_bannerbtn, bg_color: 0x7A231D, bg_opa: COVER, radius: 12, border_width: 0, shadow_width: 0, text_color: 0xFFD4CF }
    - { id: st_overlay, bg_color: 0x171B22, bg_opa: COVER, radius: 24, border_width: 3, border_color: 0xE8845C, pad_all: 0 }
    - { id: st_ghost, bg_opa: TRANSP, border_width: 0, shadow_width: 0, pad_all: 0 }
    - { id: st_modeon, bg_color: 0xE8845C, bg_opa: COVER, text_color: 0xFFFFFF }
    - { id: st_trans, bg_opa: TRANSP, border_width: 0, pad_all: 0, radius: 0 }
    # Rest screen: dark amber at night, light by day (night_enter)
    - { id: st_saver, text_color: 0x7A3A22 }
    - { id: st_saver2, text_color: 0x7A3A22 }

  # Rest: after 30 s without touches the screen with time, date,
  # temperatures and status appears (amber on black in dark theme, light in light theme).
  # A touch goes back to House.
  on_idle:
    timeout: 30s
    then:
      - if:
          condition:
            lambda: 'return !id(night_on);'
          then:
            - script.execute: { id: night_enter, night: !lambda 'return id(dark_mode);' }

  # ═══════════════ TOP LAYER: side bar, top bar, panels ═══════════════
  top_layer:
    widgets:
      # ── Navigation bar ──
      - obj:
          id: rail
          x: 0
          y: 0
          width: 104
          height: 800
          styles: st_railbox
          scrollable: false
          clickable: false
          hidden: true
          widgets:
            - label: { align: TOP_MID, y: 26, text: "\U000F11D4", text_font: i_l, text_color: 0xE8845C }
            - button:
                <<: &railbtn { x: 12, width: 80, height: 84, styles: st_rail, checked: { styles: st_railon } }
                id: rb_0
                y: 92
                widgets:
                  - label: { align: TOP_MID, y: 12, text: "\U000F02DE", text_font: i_m }
                  - label: { align: BOTTOM_MID, y: -12, text: "Casa", text_font: f_s14 }
                on_click: { script.execute: { id: nav, idx: 0 } }
            - button:
                <<: *railbtn
                id: rb_1
                y: 184
                widgets:
                  - label: { align: TOP_MID, y: 12, text: "\U000F051F", text_font: i_m }
                  - label: { align: BOTTOM_MID, y: -12, text: "Risorse", text_font: f_s14 }
                on_click: { script.execute: { id: nav, idx: 1 } }
            - button:
                <<: *railbtn
                id: rb_2
                y: 276
                widgets:
                  - label: { align: TOP_MID, y: 12, text: "\U000F0393", text_font: i_m }
                  - label: { align: BOTTOM_MID, y: -12, text: "Clima", text_font: f_s14 }
                on_click: { script.execute: { id: nav, idx: 2 } }
            - button:
                <<: *railbtn
                id: rb_3
                y: 368
                widgets:
                  - label: { align: TOP_MID, y: 12, text: "\U000F07FB", text_font: i_m }
                  - label: { align: BOTTOM_MID, y: -12, text: "Veicolo", text_font: f_s14 }
                on_click: { script.execute: { id: nav, idx: 3 } }
            - button:
                <<: *railbtn
                id: rb_4
                y: 460
                widgets:
                  - label: { align: TOP_MID, y: 12, text: "\U000F075A", text_font: i_m }
                  - label: { align: BOTTOM_MID, y: -12, text: "Media", text_font: f_s14 }
                on_click: { script.execute: { id: nav, idx: 4 } }
            - button:
                <<: *railbtn
                id: rb_5
                y: 552
                widgets:
                  - label: { align: TOP_MID, y: 12, text: "\U000F08BB", text_font: i_m }
                  - label: { align: BOTTOM_MID, y: -12, text: "Sistema", text_font: f_s14 }
                on_click: { script.execute: { id: nav, idx: 5 } }

      # ── Top bar: time, date, living area status / alarm banner ──
      - obj:
          id: topbar
          x: 124
          y: 16
          width: 1136
          height: 64
          styles: st_trans
          scrollable: false
          clickable: false
          hidden: true
          widgets:
            - label: { id: hdr_clock, x: 0, y: 4, text: "--:--", text_font: f_b48, styles: st_txt }
            - label: { id: hdr_dow, x: 150, y: 8, text: "", text_font: f_b20, styles: st_txt }
            - label: { id: hdr_date, x: 150, y: 36, text: "", text_font: f_s15, styles: st_mut }
            - obj:
                id: chip_porta
                <<: &chip { y: 8, height: 48, styles: st_card, scrollable: false, clickable: false }
                x: 508
                width: 150
                widgets:
                  - label: { id: chip_porta_i, x: 16, y: 11, text: "\U000F10AF", text_font: i_s, text_color: 0x8A909A }
                  - label: { x: 48, y: 13, text: "Porta", styles: st_mut }
            - obj:
                id: chip_gas
                <<: *chip
                x: 672
                width: 110
                widgets:
                  - label: { id: chip_gas_i, x: 16, y: 11, text: "\U000F0647", text_font: i_s, text_color: 0x8A909A }
                  - label: { x: 48, y: 13, text: "Gas", styles: st_mut }
            - obj:
                id: chip_stato
                <<: *chip
                clickable: true
                x: 796
                width: 200
                on_click:
                  - lvgl.widget.update: { id: alarm_panel, hidden: false }
                widgets:
                  - label: { id: chip_stato_i, x: 16, y: 11, text: "\U000F0CC8", text_font: i_s, text_color: 0x34C759 }
                  - label: { id: chip_stato_l, x: 48, y: 13, text: "Nessun allarme", styles: st_mut }
            - obj:
                id: banner
                x: 280
                y: 4
                width: 716
                height: 56
                styles: st_banner
                scrollable: false
                hidden: true
                widgets:
                  - label: { x: 16, y: 15, text: "\U000F0026", text_font: i_s, text_color: 0xFF5A4E }
                  - label: { id: banner_l, x: 52, y: 17, width: 506, text: "", long_mode: DOT }
                  - button:
                      x: 570
                      y: 8
                      width: 136
                      height: 40
                      styles: st_bannerbtn
                      widgets:
                        - label: { align: CENTER, text: "Ok, visto", text_font: f_s15 }
                      on_click:
                        - lambda: 'if (!id(alarm_text).empty()) id(alarm_seen) += (id(alarm_seen).empty() ? "|" : "") + id(alarm_text) + "|";'
                        - script.execute: update_alarms
            - button:
                x: 1010
                y: 4
                width: 56
                height: 56
                radius: 28
                styles: [st_card, st_mut]
                widgets:
                  - label: { align: CENTER, text: "\U000F0594", text_font: i_m }
                on_click: { script.execute: { id: night_enter, night: true } }
            - button:
                x: 1080
                y: 4
                width: 56
                height: 56
                radius: 28
                styles: [st_card, st_mut]
                widgets:
                  - label: { align: CENTER, text: "\U000F00DF", text_font: i_m }
                on_click: { script.execute: toggle_brightness_panel }

      # ── Brightness panel (opens from the icon, hides after 5 s) ──
      - obj:
          id: brightness_panel
          x: 496
          y: 92
          width: 640
          height: 76
          styles: st_overlay
          scrollable: false
          hidden: true
          widgets:
            - label: { x: 22, y: 22, text: "\U000F00DF", text_font: i_s, styles: st_mut }
            - slider:
                id: slider_brightness
                x: 70
                y: 28
                width: 460
                height: 18
                min_value: 30
                max_value: 100
                value: 100
                styles: st_track
                radius: 9
                indicator: { bg_color: 0xE8845C, radius: 9 }
                knob: { bg_color: 0xE8845C, radius: 14, pad_all: 6 }
                # on_change: touch only, not the updates from update_brightness
                on_change:
                  - globals.set: { id: display_brightness, value: !lambda 'return (int)x;' }
                  - script.execute: update_brightness
            - label: { id: brightness_pct, x: 550, y: 26, width: 70, text_align: RIGHT, text: "100%", styles: st_mut }

      # ── Alarm list (opens from the "Allarme visto" chip) ──
      - obj:
          id: alarm_panel
          x: 340
          y: 92
          width: 600
          height: 420
          styles: st_overlay
          scrollable: false
          hidden: true
          widgets:
            - label: { x: 28, y: 24, text: "\U000F0028", text_font: i_s, text_color: 0xE8845C }
            - label: { x: 64, y: 22, text: "Allarmi", text_font: f_b26, styles: st_txt }
            - label: { id: al_list, x: 28, y: 90, width: 544, height: 250, text: "Nessun allarme", styles: st_txt, long_mode: WRAP }
            - button:
                x: 28
                y: 350
                width: 544
                height: 52
                styles: st_tile
                widgets:
                  - label: { align: CENTER, text: "Chiudi", text_font: f_b20 }
                on_click:
                  - lvgl.widget.update: { id: alarm_panel, hidden: true }

      # ── Hookup post limit (opens from the Colonnina row in Resources) ──
      - obj:
          id: lim_panel
          x: 340
          y: 92
          width: 600
          height: 330
          styles: st_overlay
          scrollable: false
          hidden: true
          widgets:
            - label: { x: 28, y: 24, text: "\U000F07E7", text_font: i_s, text_color: 0xE8845C }
            - label: { x: 64, y: 22, text: "Limite colonnina", text_font: f_b26, styles: st_txt }
            - label: { x: 28, y: 76, width: 544, text: "Quanti ampere dà la colonnina del campeggio? Sopra il 90% scatta l'avviso.", styles: st_mut, long_mode: WRAP }
            - button:
                <<: &limbtn { y: 150, width: 124, height: 72, styles: st_tile, checked: { styles: st_modeon } }
                id: lim_4
                x: 28
                widgets: [label: { align: CENTER, text: "4 A", text_font: f_b26 }]
                on_click: { homeassistant.service: { service: input_number.set_value, data: { entity_id: input_number.limite_colonnina, value: "4" } } }
            - button:
                <<: *limbtn
                id: lim_6
                x: 168
                widgets: [label: { align: CENTER, text: "6 A", text_font: f_b26 }]
                on_click: { homeassistant.service: { service: input_number.set_value, data: { entity_id: input_number.limite_colonnina, value: "6" } } }
            - button:
                <<: *limbtn
                id: lim_10
                x: 308
                widgets: [label: { align: CENTER, text: "10 A", text_font: f_b26 }]
                on_click: { homeassistant.service: { service: input_number.set_value, data: { entity_id: input_number.limite_colonnina, value: "10" } } }
            - button:
                <<: *limbtn
                id: lim_16
                x: 448
                widgets: [label: { align: CENTER, text: "16 A", text_font: f_b26 }]
                on_click: { homeassistant.service: { service: input_number.set_value, data: { entity_id: input_number.limite_colonnina, value: "16" } } }
            - button:
                x: 28
                y: 254
                width: 544
                height: 52
                styles: st_tile
                widgets:
                  - label: { align: CENTER, text: "Chiudi", text_font: f_b20 }
                on_click:
                  - lvgl.widget.update: { id: lim_panel, hidden: true }

      # ── "Partenza" (departure) checklist ──
      - obj:
          id: check_panel
          x: 340
          y: 92
          width: 600
          height: 620
          styles: st_overlay
          scrollable: false
          hidden: true
          widgets:
            - label: { x: 28, y: 24, text: "\U000F08A8", text_font: i_s, text_color: 0xE8845C }
            - label: { x: 64, y: 22, text: "Prima di partire", text_font: f_b26, styles: st_txt }
            - label: { x: 28, y: 90, id: chk_0_i, text: "\U000F05E0", text_font: i_s }
            - label: { x: 64, y: 92, id: chk_0_l, text: "Porta della cellula chiusa", styles: st_txt }
            - label: { x: 28, y: 150, id: chk_1_i, text: "\U000F05E0", text_font: i_s }
            - label: { x: 64, y: 152, id: chk_1_l, text: "Porte della cabina chiuse", styles: st_txt }
            - label: { x: 28, y: 210, id: chk_2_i, text: "\U000F05E0", text_font: i_s }
            - label: { x: 64, y: 212, id: chk_2_l, text: "Pompa dell'acqua spenta", styles: st_txt }
            - label: { x: 28, y: 270, id: chk_3_i, text: "\U000F05E0", text_font: i_s }
            - label: { x: 64, y: 272, id: chk_3_l, text: "Luce esterna spenta", styles: st_txt }
            - label: { x: 28, y: 330, id: chk_4_i, text: "\U000F05E0", text_font: i_s }
            - label: { x: 64, y: 332, id: chk_4_l, text: "Condizionatore spento", styles: st_txt }
            - label: { x: 28, y: 390, id: chk_5_i, text: "\U000F05E0", text_font: i_s }
            - label: { x: 64, y: 392, id: chk_5_l, text: "Nessuna fuga di gas", styles: st_txt }
            - label: { x: 28, y: 450, id: chk_6_i, text: "\U000F05E0", text_font: i_s }
            - label: { x: 64, y: 452, id: chk_6_l, text: "Frigo acceso", styles: st_txt }
            - label: { x: 28, y: 506, width: 544, text: "Oblò, gradino e rubinetto del gas: controllali a vista.", text_font: f_s14, styles: st_mut, long_mode: WRAP }
            - button:
                x: 28
                y: 548
                width: 544
                height: 52
                styles: st_tile
                widgets:
                  - label: { align: CENTER, text: "Chiudi", text_font: f_b20 }
                on_click:
                  - lvgl.widget.update: { id: check_panel, hidden: true }

      # ── 12V loads: cut-off countdown + notice when the loads are off ──
      # With the loads off a transparent veil covers the pages (not the side
      # bar): any touch, e.g. on a light, reopens the notice.
      # Handled by update_utenze.
      - obj:
          id: ut_catch
          x: 104
          y: 0
          width: 1176
          height: 800
          styles: st_trans
          scrollable: false
          hidden: true
          on_click:
            - lvgl.widget.update: { id: ut_pop, hidden: false }
      - obj:
          id: ut_pop
          x: 0
          y: 0
          width: 1280
          height: 800
          bg_color: 0x000000
          bg_opa: 70%
          border_width: 0
          radius: 0
          scrollable: false
          hidden: true
          widgets:
            - obj:
                align: CENTER
                width: 680
                height: 520
                styles: st_overlay
                scrollable: false
                widgets:
                  - label: { id: utp_icon, align: TOP_MID, y: 24, text: "\U000F0425", text_font: i_l, text_color: 0xFF5A4E }
                  - label: { id: utp_title, align: TOP_MID, y: 82, text: "Utenze 12V spente", text_font: f_b36, styles: st_txt }
                  - label: { id: utp_sub, align: TOP_MID, y: 136, width: 600, text_align: CENTER, long_mode: WRAP, text: "", styles: st_mut }
                  - label: { id: utp_num, align: TOP_MID, y: 200, text: "90", text_font: f_b200, text_color: 0xE8845C }
                  - label: { id: utp_secs, align: TOP_MID, y: 420, text: "secondi", text_font: f_b26, styles: st_mut }
                  - button:
                      id: utp_on
                      x: 40
                      y: 290
                      width: 600
                      height: 80
                      styles: [st_tile, st_modeon]
                      widgets:
                        - label: { align: CENTER, text: "Accendi le utenze", text_font: f_b26 }
                      on_click: { script.execute: pin_open }
                  - button:
                      id: utp_close
                      x: 40
                      y: 400
                      width: 600
                      height: 64
                      styles: st_tile
                      widgets:
                        - label: { align: CENTER, text: "Chiudi", text_font: f_b20 }
                      on_click:
                        - lvgl.widget.update: { id: ut_pop, hidden: true }

      # ── Loads PIN keypad (on top of everything) ──
      - obj:
          id: pin_panel
          x: 380
          y: 55
          width: 520
          height: 690
          styles: st_overlay
          scrollable: false
          hidden: true
          widgets:
            - label: { id: pin_title, align: TOP_MID, y: 18, text: "Utenze 12V", text_font: f_b26, styles: st_txt }
            - label: { id: pin_msg, align: TOP_MID, y: 60, text: "Inserisci il PIN", styles: st_mut }
            - label: { id: pin_dots, align: TOP_MID, y: 96, text: "", text_font: f_b48, text_color: 0xE8845C }
            - button: { <<: &pinkey { width: 140, height: 92, styles: st_tile }, x: 38, y: 168, widgets: [label: { align: CENTER, text: "1", text_font: f_b36 }], on_click: { script.execute: { id: pin_key, d: "1" } } }
            - button: { <<: *pinkey, x: 190, y: 168, widgets: [label: { align: CENTER, text: "2", text_font: f_b36 }], on_click: { script.execute: { id: pin_key, d: "2" } } }
            - button: { <<: *pinkey, x: 342, y: 168, widgets: [label: { align: CENTER, text: "3", text_font: f_b36 }], on_click: { script.execute: { id: pin_key, d: "3" } } }
            - button: { <<: *pinkey, x: 38, y: 272, widgets: [label: { align: CENTER, text: "4", text_font: f_b36 }], on_click: { script.execute: { id: pin_key, d: "4" } } }
            - button: { <<: *pinkey, x: 190, y: 272, widgets: [label: { align: CENTER, text: "5", text_font: f_b36 }], on_click: { script.execute: { id: pin_key, d: "5" } } }
            - button: { <<: *pinkey, x: 342, y: 272, widgets: [label: { align: CENTER, text: "6", text_font: f_b36 }], on_click: { script.execute: { id: pin_key, d: "6" } } }
            - button: { <<: *pinkey, x: 38, y: 376, widgets: [label: { align: CENTER, text: "7", text_font: f_b36 }], on_click: { script.execute: { id: pin_key, d: "7" } } }
            - button: { <<: *pinkey, x: 190, y: 376, widgets: [label: { align: CENTER, text: "8", text_font: f_b36 }], on_click: { script.execute: { id: pin_key, d: "8" } } }
            - button: { <<: *pinkey, x: 342, y: 376, widgets: [label: { align: CENTER, text: "9", text_font: f_b36 }], on_click: { script.execute: { id: pin_key, d: "9" } } }
            - button: { <<: *pinkey, x: 38, y: 480, widgets: [label: { align: CENTER, text: "C", text_font: f_b36 }], on_click: { script.execute: pin_clear } }
            - button: { <<: *pinkey, x: 190, y: 480, widgets: [label: { align: CENTER, text: "0", text_font: f_b36 }], on_click: { script.execute: { id: pin_key, d: "0" } } }
            - button: { <<: *pinkey, x: 342, y: 480, styles: [st_tile, st_modeon], widgets: [label: { align: CENTER, text: "OK", text_font: f_b26 }], on_click: { script.execute: pin_check } }
            - button:
                x: 38
                y: 592
                width: 444
                height: 60
                styles: st_tile
                widgets:
                  - label: { align: CENTER, text: "Annulla", text_font: f_b20 }
                on_click: { script.execute: pin_close }

  pages:
    # ═══════════════ SPLASH ═══════════════
    - id: page_splash
      skip: true
      bg_color: 0x0D1117
      widgets:
        - label: { align: CENTER, y: -67, text: "monitor", text_font: mont_76, text_color: 0xE8845C }
        - label: { align: CENTER, y: 17, text: "camper", text_font: mont_76, text_color: 0xF0F0F0 }
        - spinner:
            align: CENTER
            y: 167
            width: 70
            height: 73
            spin_time: 1s
            arc_length: 60deg
            arc_color: 0x21262D
            indicator: { arc_color: 0xE8845C }

    # ═══════════════ HOUSE ═══════════════
    - id: page_home
      styles: st_page
      widgets:
        # ── Floor plan with the 15 lights ──
        - obj:
            id: card_plan
            x: 124
            y: 96
            width: 1136
            height: 360
            styles: st_card
            scrollable: false
            widgets:
              - image: { id: plan_img, x: 20, y: 20, src: img_plan_dark }
              # Living area entrance door (right side = top with the nose to the left)
              - obj: { id: door_mark, x: 370, y: 66, width: 62, height: 8, radius: 4, bg_color: 0x34C759, border_width: 0, clickable: false, scrollable: false }
              # Light buttons: floor plan rotated 180° (nose/attic to the left)
              - button:
                  <<: &lt { width: 52, height: 52, radius: 26, checkable: true, styles: st_light, checked: { styles: st_on } }
                  id: lt_mans1
                  x: 188
                  y: 202
                  widgets:
                    - label: { align: TOP_MID, y: 7, text: "\U000F17C9", text_font: i_xs }
                    - label: { align: BOTTOM_MID, y: -6, text: "Mans. 1", text_font: f_t11 }
                  on_click: { homeassistant.service: { service: light.toggle, data: { entity_id: light.esp32_mansarda_luce_1 } } }
              - button:
                  <<: *lt
                  id: lt_mans2
                  x: 188
                  y: 101
                  widgets:
                    - label: { align: TOP_MID, y: 7, text: "\U000F17C9", text_font: i_xs }
                    - label: { align: BOTTOM_MID, y: -6, text: "Mans. 2", text_font: f_t11 }
                  on_click: { homeassistant.service: { service: light.toggle, data: { entity_id: light.esp32_mansarda_luce_2 } } }
              - button:
                  <<: *lt
                  id: lt_leddin
                  x: 362
                  y: 216
                  widgets:
                    - label: { align: TOP_MID, y: 7, text: "\U000F1051", text_font: i_xs }
                    - label: { align: BOTTOM_MID, y: -6, text: "Led", text_font: f_t11 }
                  on_click: { homeassistant.service: { service: light.toggle, data: { entity_id: light.kincony_kc868_a16_luce_9 } } }
              - button:
                  <<: *lt
                  id: lt_tavolo
                  x: 304
                  y: 176
                  widgets:
                    - label: { align: TOP_MID, y: 7, text: "\U000F05BC", text_font: i_xs }
                    - label: { align: BOTTOM_MID, y: -6, text: "Tavolo", text_font: f_t11 }
                  on_click: { homeassistant.service: { service: light.toggle, data: { entity_id: light.shellyplus1_441793a44110_switch_0 } } }
              - button:
                  <<: *lt
                  id: lt_princ
                  x: 379
                  y: 129
                  widgets:
                    - label: { align: TOP_MID, y: 7, text: "\U000F0769", text_font: i_xs }
                    - label: { align: BOTTOM_MID, y: -6, text: "Princip.", text_font: f_t11 }
                  on_click: { homeassistant.service: { service: light.toggle, data: { entity_id: light.kincony_kc868_a16_luce_1 } } }
              - button:
                  <<: *lt
                  id: lt_panca
                  x: 300
                  y: 78
                  widgets:
                    - label: { align: TOP_MID, y: 7, text: "\U000F179B", text_font: i_xs }
                    - label: { align: BOTTOM_MID, y: -6, text: "Panca", text_font: f_t11 }
                  on_click: { homeassistant.service: { service: light.toggle, data: { entity_id: light.faretti_panca } } }
              - button:
                  <<: *lt
                  id: lt_esterna
                  x: 373
                  y: 2
                  widgets:
                    - label: { align: TOP_MID, y: 7, text: "\U000F1054", text_font: i_xs }
                    - label: { align: BOTTOM_MID, y: -6, text: "Esterna", text_font: f_t11 }
                  on_click: { homeassistant.service: { service: light.toggle, data: { entity_id: light.kincony_kc868_a16_luce_12 } } }
              - button:
                  <<: *lt
                  id: lt_cucina
                  x: 435
                  y: 193
                  widgets:
                    - label: { align: TOP_MID, y: 7, text: "\U000F04DE", text_font: i_xs }
                    - label: { align: BOTTOM_MID, y: -6, text: "Cucina", text_font: f_t11 }
                  on_click: { homeassistant.service: { service: light.toggle, data: { entity_id: light.kincony_kc868_a16_luce_3 } } }
              - button:
                  <<: *lt
                  id: lt_ledcuc
                  x: 454
                  y: 256
                  widgets:
                    - label: { align: TOP_MID, y: 7, text: "\U000F1051", text_font: i_xs }
                    - label: { align: BOTTOM_MID, y: -6, text: "Led", text_font: f_t11 }
                  on_click: { homeassistant.service: { service: light.toggle, data: { entity_id: light.esp32_cucina_led_switch } } }
              - button:
                  <<: *lt
                  id: lt_corr
                  x: 492
                  y: 144
                  widgets:
                    - label: { align: TOP_MID, y: 7, text: "\U000F0583", text_font: i_xs }
                    - label: { align: BOTTOM_MID, y: -6, text: "Corrid.", text_font: f_t11 }
                  on_click: { homeassistant.service: { service: light.toggle, data: { entity_id: light.kincony_kc868_a16_luce_2 } } }
              - button:
                  <<: *lt
                  id: lt_doccia
                  x: 537
                  y: 222
                  widgets:
                    - label: { align: TOP_MID, y: 7, text: "\U000F09A1", text_font: i_xs }
                    - label: { align: BOTTOM_MID, y: -6, text: "Doccia", text_font: f_t11 }
                  on_click: { homeassistant.service: { service: light.toggle, data: { entity_id: light.shelly1_34945479f8e1 } } }
              - button:
                  <<: *lt
                  id: lt_bagno
                  x: 531
                  y: 82
                  widgets:
                    - label: { align: TOP_MID, y: 7, text: "\U000F09AB", text_font: i_xs }
                    - label: { align: BOTTOM_MID, y: -6, text: "Bagno", text_font: f_t11 }
                  on_click: { homeassistant.service: { service: light.toggle, data: { entity_id: light.kincony_kc868_a16_luce_4 } } }
              - button:
                  <<: *lt
                  id: lt_letto1
                  x: 660
                  y: 230
                  widgets:
                    - label: { align: TOP_MID, y: 7, text: "\U000F17D0", text_font: i_xs }
                    - label: { align: BOTTOM_MID, y: -6, text: "Letto 1", text_font: f_t11 }
                  on_click: { homeassistant.service: { service: light.toggle, data: { entity_id: light.esp32_letto_luce_letto_1 } } }
              - button:
                  <<: *lt
                  id: lt_letto2
                  x: 660
                  y: 73
                  widgets:
                    - label: { align: TOP_MID, y: 7, text: "\U000F17D0", text_font: i_xs }
                    - label: { align: BOTTOM_MID, y: -6, text: "Letto 2", text_font: f_t11 }
                  on_click: { homeassistant.service: { service: light.toggle, data: { entity_id: light.esp32_letto_luce_letto_2 } } }
              - button:
                  <<: *lt
                  id: lt_gavone
                  x: 746
                  y: 146
                  widgets:
                    - label: { align: TOP_MID, y: 7, text: "\U000F12D3", text_font: i_xs }
                    - label: { align: BOTTOM_MID, y: -6, text: "Gavone", text_font: f_t11 }
                  on_click: { homeassistant.service: { service: light.toggle, data: { entity_id: light.shellyplus1_d0ef76d9cac0_switch_0 } } }
              # Fridge: status only, blue = on. Vevor in the locker, Domotic on the symbol near the door
              - obj:
                  <<: &fr { width: 52, height: 52, radius: 26, scrollable: false, styles: st_light, checked: { styles: st_cold } }
                  id: fr_vevor
                  x: 746
                  y: 88
                  on_click:
                    - if:
                        condition:
                          lambda: 'return id(ha_frigo_state).state == "off";'
                        then:
                          - homeassistant.service: { service: climate.turn_on, data: { entity_id: climate.vevor_c50_fridge } }
                        else:
                          - homeassistant.service: { service: climate.turn_off, data: { entity_id: climate.vevor_c50_fridge } }
                  widgets:
                    - label: { align: TOP_MID, y: 7, text: "\U000F028F", text_font: i_xs }
                    - label: { align: BOTTOM_MID, y: -6, text: "Vevor", text_font: f_t11 }
              - obj:
                  <<: *fr
                  id: fr_dom
                  clickable: false
                  x: 435
                  y: 69
                  widgets:
                    - label: { align: TOP_MID, y: 7, text: "\U000F028F", text_font: i_xs }
                    - label: { align: BOTTOM_MID, y: -6, text: "Frigo", text_font: f_t11 }

              # ── Right column: house status ──
              - label: { x: 818, y: 18, text: "\U000F11D4", text_font: i_s, text_color: 0xE8845C }
              - label: { x: 852, y: 22, text: "LA CASA", text_font: f_h15, styles: st_mut, text_letter_space: 2 }
              - label: { id: lights_count, x: 818, y: 56, text: "--", text_font: f_b20, text_color: 0xF5B461 }
              - label: { x: 818, y: 98, text: "\U000F156D", text_font: i_s, styles: st_mut }
              - label: { x: 852, y: 100, text: "Dinette", styles: st_txt }
              - label: { id: h_t_din, x: 1000, y: 99, width: 116, text_align: RIGHT, text: "--", text_font: f_b20, styles: st_txt }
              - obj: { x: 818, y: 138, width: 298, height: 1, styles: st_sep, clickable: false }
              - label: { x: 818, y: 148, text: "\U000F0097", text_font: i_s, styles: st_mut }
              - label: { x: 852, y: 150, text: "Mansarda", styles: st_txt }
              - label: { id: h_t_mans, x: 1000, y: 149, width: 116, text_align: RIGHT, text: "--", text_font: f_b20, styles: st_txt }
              - obj: { x: 818, y: 188, width: 298, height: 1, styles: st_sep, clickable: false }
              - label: { x: 818, y: 198, text: "\U000F0099", text_font: i_s, styles: st_mut }
              - label: { x: 852, y: 200, text: "Letto", styles: st_txt }
              - label: { id: h_t_letto, x: 1000, y: 199, width: 116, text_align: RIGHT, text: "--", text_font: f_b20, styles: st_txt }
              - obj: { x: 818, y: 238, width: 298, height: 1, styles: st_sep, clickable: false }
              - label: { id: h_porta_i, x: 818, y: 248, text: "\U000F10AF", text_font: i_s, text_color: 0x8A909A }
              - label: { x: 852, y: 250, text: "Porta", styles: st_txt }
              - label: { id: h_porta_v, x: 980, y: 249, width: 136, text_align: RIGHT, text: "--", text_font: f_b20, text_color: 0x8A909A }
              - button:
                  x: 818
                  y: 286
                  width: 298
                  height: 56
                  styles: [st_tile, st_modeon]
                  widgets:
                    - label: { align: CENTER, x: -72, text: "\U000F0E50", text_font: i_s }
                    - label: { align: CENTER, x: 16, text: "Spegni tutte", text_font: f_b20 }
                  on_click:
                    - homeassistant.service:
                        service: light.turn_off
                        data:
                          entity_id: "light.kincony_kc868_a16_luce_1, light.shellyplus1_441793a44110_switch_0, light.faretti_panca, light.kincony_kc868_a16_luce_9, light.kincony_kc868_a16_luce_2, light.kincony_kc868_a16_luce_3, light.esp32_cucina_led_switch, light.kincony_kc868_a16_luce_4, light.shelly1_34945479f8e1, light.shellyplus1_d0ef76d9cac0_switch_0, light.kincony_kc868_a16_luce_12, light.esp32_mansarda_luce_1, light.esp32_mansarda_luce_2, light.esp32_letto_luce_letto_1, light.esp32_letto_luce_letto_2"

        # ── Resources (large percentage, small estimate) ──
        - obj:
            x: 124
            y: 472
            width: 620
            height: 208
            styles: st_card
            scrollable: false
            widgets:
              - label: { x: 20, y: 18, text: "\U000F051F", text_font: i_s, text_color: 0xE8845C }
              - label: { x: 52, y: 22, text: "RISORSE", text_font: f_h15, styles: st_mut, text_letter_space: 2 }
              - label: { id: hm_head, x: 180, y: 20, width: 420, text_align: RIGHT, text: "", styles: st_txt, long_mode: DOT }
              # Battery
              - label: { x: 20, y: 68, text: "\U000F0080", text_font: i_s, text_color: 0x34C759 }
              - label: { x: 48, y: 71, text: "Batteria", text_font: f_s15, styles: st_mut }
              - label: { id: hm_batt_v, x: 20, y: 100, text: "--", text_font: f_b36, styles: st_txt }
              - bar: { id: hm_batt_bar, x: 20, y: 148, width: 130, height: 10, value: 0, styles: st_track, radius: 5, indicator: { bg_color: 0x34C759, radius: 5 } }
              - label: { id: hm_batt_d, x: 20, y: 166, text: "", text_font: f_s14, styles: st_mut }
              # Water
              - label: { x: 171, y: 68, text: "\U000F058C", text_font: i_s, text_color: 0x5AA9E6 }
              - label: { x: 199, y: 71, text: "Acqua", text_font: f_s15, styles: st_mut }
              - label: { id: hm_acq_v, x: 171, y: 100, text: "--", text_font: f_b36, styles: st_txt }
              - bar: { id: hm_acq_bar, x: 171, y: 148, width: 130, height: 10, value: 0, styles: st_track, radius: 5, indicator: { bg_color: 0x5AA9E6, radius: 5 } }
              - label: { id: hm_acq_d, x: 171, y: 166, text: "", text_font: f_s14, styles: st_mut }
              # Gas
              - label: { x: 322, y: 68, text: "\U000F0647", text_font: i_s, text_color: 0xF0A500 }
              - label: { x: 350, y: 71, text: "Gas", text_font: f_s15, styles: st_mut }
              - label: { id: hm_gas_v, x: 322, y: 100, text: "--", text_font: f_b36, styles: st_txt }
              - bar: { id: hm_gas_bar, x: 322, y: 148, width: 130, height: 10, value: 0, styles: st_track, radius: 5, indicator: { bg_color: 0xF0A500, radius: 5 } }
              - label: { id: hm_gas_d, x: 322, y: 166, text: "", text_font: f_s14, styles: st_mut }
              # Greys: estimate from fresh water use, realigned by the full probe
              - label: { x: 473, y: 68, text: "\U000F1855", text_font: i_s, text_color: 0xA08868 }
              - label: { x: 501, y: 71, text: "Grigie", text_font: f_s15, styles: st_mut }
              - label: { id: hm_gri_v, x: 473, y: 100, text: "--", text_font: f_b36, styles: st_txt }
              - bar: { id: hm_gri_bar, x: 473, y: 148, width: 130, height: 10, value: 0, styles: st_track, radius: 5, indicator: { bg_color: 0xA08868, radius: 5 } }
              - label: { id: hm_gri_d, x: 473, y: 166, text: "", text_font: f_s14, styles: st_mut }

        # ── Inside / outside ──
        - obj:
            x: 760
            y: 472
            width: 250
            height: 208
            styles: st_card
            scrollable: false
            widgets:
              - label: { x: 20, y: 18, text: "\U000F0F55", text_font: i_s, text_color: 0xE8845C }
              - label: { x: 52, y: 22, text: "DENTRO", text_font: f_h15, styles: st_mut, text_letter_space: 2 }
              - label: { id: dentro_ur, x: 150, y: 20, width: 80, text_align: RIGHT, text: "", styles: st_mut }
              - label: { id: dentro_v, x: 20, y: 58, text: "--", text_font: f_b56, styles: st_txt }
              - label: { id: meteo_ico, x: 18, y: 146, text: "\U000F0595", text_font: i_m, text_color: 0xF0A500 }
              - label: { id: fuori_v, x: 58, y: 153, width: 176, height: 22, text: "--", styles: st_mut, long_mode: DOT }

        # ── Systems status (tap on Pompa = on/off) ──
        - obj:
            x: 1026
            y: 472
            width: 234
            height: 208
            styles: st_card
            scrollable: false
            widgets:
              - label: { x: 18, y: 14, text: "\U000F0238", text_font: i_s, styles: st_dim }
              - label: { x: 52, y: 16, text: "Webasto", styles: st_txt }
              - label: { id: st_web_v, x: 110, y: 17, width: 106, text_align: RIGHT, text: "n.c.", text_font: f_s15, styles: st_mut }
              - obj: { x: 18, y: 52, width: 198, height: 1, styles: st_sep, clickable: false }
              - label: { id: st_clima_i, x: 18, y: 64, text: "\U000F001B", text_font: i_s, styles: st_dim }
              - label: { x: 52, y: 66, text: "Clima", styles: st_txt }
              - label: { id: st_clima_v, x: 100, y: 67, width: 116, text_align: RIGHT, text: "--", text_font: f_s15, styles: st_mut }
              - obj: { x: 18, y: 102, width: 198, height: 1, styles: st_sep, clickable: false }
              - label: { x: 18, y: 114, text: "\U000F028F", text_font: i_s, text_color: 0x5AA9E6 }
              - label: { x: 52, y: 116, text: "Frigo", styles: st_txt }
              - label: { id: st_frigo_v, x: 100, y: 117, width: 116, text_align: RIGHT, text: "--", text_font: f_s15, styles: st_mut }
              - obj: { x: 18, y: 152, width: 198, height: 1, styles: st_sep, clickable: false }
              - label: { x: 18, y: 164, text: "\U000F058F", text_font: i_s, text_color: 0x5AA9E6 }
              - label: { x: 52, y: 166, text: "Pompa", styles: st_txt }
              - label: { id: st_pompa_v, x: 110, y: 165, width: 106, text_align: RIGHT, text: "--", text_font: f_b20, text_color: 0x8A909A }
              - button:
                  x: 0
                  y: 154
                  width: 234
                  height: 54
                  styles: st_ghost
                  on_click: { homeassistant.service: { service: switch.toggle, data: { entity_id: switch.esp32_serbatoio_acqua_pompa } } }

        # ── Scenes ──
        - button:
            <<: &scene { y: 696, width: 214, height: 88, styles: [st_card, st_txt] }
            x: 124
            widgets:
              - label: { align: LEFT_MID, x: 24, text: "\U000F059C", text_font: i_m, text_color: 0xE8845C }
              - label: { align: LEFT_MID, x: 68, text: "Buongiorno", text_font: f_b20 }
            on_click: { homeassistant.service: { service: script.turn_on, data: { entity_id: script.camper_buongiorno } } }
        - button:
            <<: *scene
            x: 354
            widgets:
              - label: { align: LEFT_MID, x: 40, text: "\U000F0A48", text_font: i_m, text_color: 0xE8845C }
              - label: { align: LEFT_MID, x: 90, text: "Esco", text_font: f_b20 }
            on_click: { homeassistant.service: { service: input_boolean.turn_on, data: { entity_id: input_boolean.esco_camper } } }
        # Dinner: table and bench spotlights, main light off
        - button:
            <<: *scene
            x: 584
            widgets:
              - label: { align: LEFT_MID, x: 40, text: "\U000F0A70", text_font: i_m, text_color: 0xE8845C }
              - label: { align: LEFT_MID, x: 90, text: "Cena", text_font: f_b20 }
            on_click:
              - homeassistant.service:
                  service: light.turn_on
                  data: { entity_id: "light.shellyplus1_441793a44110_switch_0, light.faretti_panca" }
              - homeassistant.service:
                  service: light.turn_off
                  data: { entity_id: light.kincony_kc868_a16_luce_1 }
        # Night: HA goodnight script + Night screen on the panel
        - button:
            <<: *scene
            x: 814
            widgets:
              - label: { align: LEFT_MID, x: 40, text: "\U000F0594", text_font: i_m, text_color: 0xE8845C }
              - label: { align: LEFT_MID, x: 90, text: "Notte", text_font: f_b20 }
            on_click:
              - homeassistant.service: { service: script.turn_on, data: { entity_id: script.camper_buonanotte } }
              - script.execute: { id: night_enter, night: true }
        - button:
            <<: *scene
            x: 1044
            width: 216
            widgets:
              - label: { align: LEFT_MID, x: 28, text: "\U000F08A8", text_font: i_m, text_color: 0xE8845C }
              - label: { align: LEFT_MID, x: 74, text: "Partenza", text_font: f_b20 }
            on_click:
              - script.execute: update_checklist
              - lvgl.widget.update: { id: check_panel, hidden: false }

    # ═══════════════ RESOURCES ═══════════════
    - id: page_risorse
      styles: st_page
      widgets:
        - obj:
            x: 124
            y: 96
            width: 1136
            height: 112
            styles: st_card
            scrollable: false
            widgets:
              - label: { x: 26, y: 34, text: "\U000F051F", text_font: i_l, text_color: 0xE8845C }
              - label: { x: 96, y: 18, text: "PUOI RESTARE FERMO", text_font: f_h15, styles: st_mut, text_letter_space: 2 }
              - label: { id: rs_head, x: 96, y: 40, width: 600, text: "--", text_font: f_b48, styles: st_txt, long_mode: DOT }
              - label: { id: rs_para, x: 700, y: 20, width: 416, text: "", styles: st_mut, long_mode: WRAP }

        # Four resource cards: header, large %, bar, 3 rows
        - obj:
            <<: &rescard { y: 224, width: 272, height: 292, styles: st_card, scrollable: false }
            x: 124
            widgets:
              - label: { x: 20, y: 18, text: "\U000F0080", text_font: i_s, text_color: 0x34C759 }
              - label: { x: 52, y: 22, text: "BATTERIA", text_font: f_h15, styles: st_mut, text_letter_space: 2 }
              - label: { id: rs_batt_u, x: 150, y: 20, width: 102, text_align: RIGHT, text: "", styles: st_mut }
              - label: { id: rs_batt_v, x: 20, y: 52, text: "--", text_font: f_b56, styles: st_txt }
              - bar: { id: rs_batt_bar, x: 20, y: 122, width: 232, height: 18, value: 0, styles: st_track, radius: 9, indicator: { bg_color: 0x34C759, radius: 9 } }
              - label: { x: 20, y: 162, text: "Stima", styles: st_mut }
              - label: { id: rs_batt_k1, x: 110, y: 161, width: 142, text_align: RIGHT, text: "--", text_font: f_b20, styles: st_txt }
              - obj: { x: 20, y: 196, width: 232, height: 1, styles: st_sep, clickable: false }
              - label: { x: 20, y: 208, text: "Adesso", styles: st_mut }
              - label: { id: rs_batt_k2, x: 110, y: 207, width: 142, text_align: RIGHT, text: "--", text_font: f_b20, styles: st_txt }
              - obj: { x: 20, y: 242, width: 232, height: 1, styles: st_sep, clickable: false }
              - label: { x: 20, y: 254, text: "Al giorno", styles: st_mut }
              - label: { id: rs_batt_k3, x: 110, y: 253, width: 142, text_align: RIGHT, text: "--", text_font: f_b20, styles: st_txt }
        - obj:
            <<: *rescard
            x: 412
            widgets:
              - label: { x: 20, y: 18, text: "\U000F058C", text_font: i_s, text_color: 0x5AA9E6 }
              - label: { x: 52, y: 22, text: "ACQUA", text_font: f_h15, styles: st_mut, text_letter_space: 2 }
              - label: { id: rs_acq_u, x: 150, y: 20, width: 102, text_align: RIGHT, text: "", styles: st_mut }
              - label: { id: rs_acq_v, x: 20, y: 52, text: "--", text_font: f_b56, styles: st_txt }
              - bar: { id: rs_acq_bar, x: 20, y: 122, width: 232, height: 18, value: 0, styles: st_track, radius: 9, indicator: { bg_color: 0x5AA9E6, radius: 9 } }
              - label: { x: 20, y: 162, text: "Stima", styles: st_mut }
              - label: { id: rs_acq_k1, x: 110, y: 161, width: 142, text_align: RIGHT, text: "--", text_font: f_b20, styles: st_txt }
              - obj: { x: 20, y: 196, width: 232, height: 1, styles: st_sep, clickable: false }
              - label: { x: 20, y: 208, text: "Pompa", styles: st_mut }
              - label: { id: rs_acq_k2, x: 110, y: 207, width: 142, text_align: RIGHT, text: "--", text_font: f_b20, styles: st_txt }
              - obj: { x: 20, y: 242, width: 232, height: 1, styles: st_sep, clickable: false }
              - label: { x: 20, y: 254, text: "Al giorno", styles: st_mut }
              - label: { id: rs_acq_k3, x: 110, y: 253, width: 142, text_align: RIGHT, text: "--", text_font: f_b20, styles: st_txt }
        - obj:
            <<: *rescard
            x: 700
            widgets:
              - label: { x: 20, y: 18, text: "\U000F0647", text_font: i_s, text_color: 0xF0A500 }
              - label: { x: 52, y: 22, text: "GAS", text_font: f_h15, styles: st_mut, text_letter_space: 2 }
              - label: { id: rs_gas_u, x: 150, y: 20, width: 102, text_align: RIGHT, text: "", styles: st_mut }
              - label: { id: rs_gas_v, x: 20, y: 52, text: "--", text_font: f_b56, styles: st_txt }
              - bar: { id: rs_gas_bar, x: 20, y: 122, width: 232, height: 18, value: 0, styles: st_track, radius: 9, indicator: { bg_color: 0xF0A500, radius: 9 } }
              - label: { x: 20, y: 162, text: "Stima", styles: st_mut }
              - label: { id: rs_gas_k1, x: 110, y: 161, width: 142, text_align: RIGHT, text: "--", text_font: f_b20, styles: st_txt }
              - obj: { x: 20, y: 196, width: 232, height: 1, styles: st_sep, clickable: false }
              - label: { x: 20, y: 208, text: "Fuga", styles: st_mut }
              - label: { id: rs_gas_k2, x: 110, y: 207, width: 142, text_align: RIGHT, text: "--", text_font: f_b20, styles: st_txt }
              - obj: { x: 20, y: 242, width: 232, height: 1, styles: st_sep, clickable: false }
              - label: { x: 20, y: 254, text: "Al giorno", styles: st_mut }
              - label: { id: rs_gas_k3, x: 110, y: 253, width: 142, text_align: RIGHT, text: "--", text_font: f_b20, styles: st_txt }
        - obj:
            <<: *rescard
            x: 988
            widgets:
              - label: { x: 20, y: 18, text: "\U000F1855", text_font: i_s, text_color: 0xA08868 }
              - label: { x: 52, y: 22, text: "GRIGIE", text_font: f_h15, styles: st_mut, text_letter_space: 2 }
              - label: { id: rs_gri_u, x: 150, y: 20, width: 102, text_align: RIGHT, text: "", styles: st_mut }
              - label: { id: rs_gri_v, x: 20, y: 52, text: "--", text_font: f_b56, styles: st_txt }
              - bar: { id: rs_gri_bar, x: 20, y: 122, width: 232, height: 18, value: 0, styles: st_track, radius: 9, indicator: { bg_color: 0xA08868, radius: 9 } }
              - label: { x: 20, y: 162, text: "Sonde", styles: st_mut }
              - label: { id: rs_gri_k1, x: 110, y: 161, width: 142, text_align: RIGHT, text: "--", text_font: f_b20, styles: st_txt }
              - obj: { x: 20, y: 196, width: 232, height: 1, styles: st_sep, clickable: false }
              # For tanks emptied before the water reaches the full probe
              - button:
                  x: 20
                  y: 212
                  width: 232
                  height: 64
                  styles: st_tile
                  widgets:
                    - label: { align: CENTER, text: "Svuotate (tieni premuto)", text_font: f_s15 }
                  on_long_press:
                    - lambda: 'id(grey_est_l) = 0; id(update_grey).execute();'

        # Charging
        - obj:
            x: 124
            y: 532
            width: 380
            height: 252
            styles: st_card
            scrollable: false
            widgets:
              - label: { x: 20, y: 18, text: "\U000F140B", text_font: i_s, text_color: 0x34C759 }
              - label: { x: 52, y: 22, text: "RICARICA", text_font: f_h15, styles: st_mut, text_letter_space: 2 }
              - label: { x: 20, y: 56, text: "\U000F06A5", text_font: i_s, styles: st_mut }
              - label: { x: 56, y: 58, text: "Sorgente", styles: st_txt }
              - label: { id: rc_src, x: 170, y: 58, width: 190, text_align: RIGHT, text: "--", styles: st_mut, long_mode: DOT }
              - obj: { x: 20, y: 92, width: 340, height: 1, styles: st_sep, clickable: false }
              - label: { x: 20, y: 102, text: "\U000F0084", text_font: i_s, styles: st_mut }
              - label: { x: 56, y: 104, text: "Caricabatterie", styles: st_txt }
              - label: { id: rc_mode, x: 200, y: 104, width: 160, text_align: RIGHT, text: "--", styles: st_mut, long_mode: DOT }
              - obj: { x: 20, y: 138, width: 340, height: 1, styles: st_sep, clickable: false }
              - label: { x: 20, y: 148, text: "\U000F1904", text_font: i_s, text_color: 0xF0A500 }
              - label: { x: 56, y: 150, text: "Batteria", styles: st_txt }
              - label: { id: rc_pow, x: 200, y: 148, width: 160, text_align: RIGHT, text: "--", text_font: f_b20, styles: st_txt }
              - obj: { x: 20, y: 184, width: 340, height: 1, styles: st_sep, clickable: false }
              # Hookup post: W · A / limit, bar towards the limit; a touch opens the limit picker
              - label: { id: rc_rete_i, x: 20, y: 194, text: "\U000F07E7", text_font: i_s, text_color: 0x5A606A }
              - label: { x: 56, y: 196, text: "Colonnina", styles: st_txt }
              - obj:
                  x: 170
                  y: 192
                  width: 190
                  height: 28
                  styles: st_trans
                  scrollable: false
                  clickable: false
                  layout: { type: flex, flex_flow: ROW, flex_align_main: END, flex_align_cross: END, pad_column: 6 }
                  widgets:
                    - label: { id: rc_rete_w, text: "", text_font: f_s14, styles: st_mut, hidden: true }
                    - label: { id: rc_rete_a, text: "", text_font: f_b20, styles: st_txt, hidden: true }
                    - label: { id: rc_rete_l, text: "", styles: st_mut, hidden: true }
                    - label: { id: rc_rete_s, text: "non collegata", styles: st_mut }
              - bar: { id: rc_rete_bar, x: 20, y: 230, width: 340, height: 8, value: 0, styles: st_track, radius: 4, indicator: { bg_color: 0x34C759, radius: 4 } }
              - obj:
                  x: 0
                  y: 186
                  width: 380
                  height: 66
                  styles: st_trans
                  scrollable: false
                  on_click:
                    - lvgl.widget.update: { id: lim_panel, hidden: false }

        # Last 3 days trend (hourly samples stored on the panel)
        - obj:
            x: 520
            y: 532
            width: 740
            height: 252
            styles: st_card
            scrollable: false
            widgets:
              - label: { x: 20, y: 18, text: "\U000F012A", text_font: i_s, text_color: 0xE8845C }
              - label: { x: 52, y: 22, text: "ULTIMI 3 GIORNI", text_font: f_h15, styles: st_mut, text_letter_space: 2 }
              - obj: { x: 420, y: 29, width: 14, height: 4, radius: 2, bg_color: 0x34C759, border_width: 0, clickable: false }
              - label: { x: 440, y: 22, text: "Batteria", text_font: f_s14, styles: st_mut }
              - obj: { x: 530, y: 29, width: 14, height: 4, radius: 2, bg_color: 0x5AA9E6, border_width: 0, clickable: false }
              - label: { x: 550, y: 22, text: "Acqua", text_font: f_s14, styles: st_mut }
              - obj: { x: 626, y: 29, width: 14, height: 4, radius: 2, bg_color: 0xF0A500, border_width: 0, clickable: false }
              - label: { x: 646, y: 22, text: "Gas", text_font: f_s14, styles: st_mut }
              - obj:
                  x: 20
                  y: 60
                  width: 700
                  height: 160
                  styles: st_trans
                  scrollable: false
                  clickable: false
                  widgets:
                    - obj: { x: 0, y: 0, width: 700, height: 1, styles: st_sep, clickable: false }
                    - obj: { x: 0, y: 80, width: 700, height: 1, styles: st_sep, clickable: false }
                    - obj: { x: 0, y: 159, width: 700, height: 1, styles: st_sep, clickable: false }
                    - obj: { x: 233, y: 0, width: 1, height: 160, styles: st_sep, clickable: false }
                    - obj: { x: 466, y: 0, width: 1, height: 160, styles: st_sep, clickable: false }
                    - line: { id: ch_gas, x: 0, y: 0, points: [{ x: 0, y: 159 }, { x: 1, y: 159 }], line_width: 3, line_color: 0xF0A500, line_rounded: true }
                    - line: { id: ch_acq, x: 0, y: 0, points: [{ x: 0, y: 159 }, { x: 1, y: 159 }], line_width: 3, line_color: 0x5AA9E6, line_rounded: true }
                    - line: { id: ch_batt, x: 0, y: 0, points: [{ x: 0, y: 159 }, { x: 1, y: 159 }], line_width: 3, line_color: 0x34C759, line_rounded: true }
              - label: { x: 20, y: 226, text: "3 giorni fa", text_font: f_s14, styles: st_dim }
              - label: { x: 256, y: 226, text: "2 giorni fa", text_font: f_s14, styles: st_dim }
              - label: { x: 489, y: 226, text: "ieri", text_font: f_s14, styles: st_dim }
              - label: { x: 680, y: 226, text: "ora", text_font: f_s14, styles: st_dim }

    # ═══════════════ CLIMATE ═══════════════
    - id: page_clima
      styles: st_page
      widgets:
        # ── Vevor fridge ──
        - obj:
            x: 124
            y: 96
            width: 402
            height: 688
            styles: st_card
            scrollable: false
            widgets:
              - label: { x: 20, y: 18, text: "\U000F028F", text_font: i_s, text_color: 0x5AA9E6 }
              - label: { x: 52, y: 22, text: "FRIGO VEVOR", text_font: f_h15, styles: st_mut, text_letter_space: 2 }
              - label: { id: fr_state, x: 250, y: 20, width: 132, text_align: RIGHT, text: "--", styles: st_mut }
              - arc:
                  <<: &dial { x: 36, y: 70, width: 330, height: 330, adjustable: false, clickable: false, styles: st_arctrack, knob: { bg_opa: TRANSP, pad_all: 0 } }
                  id: fr_arc
                  min_value: -20
                  max_value: 20
                  value: 4
                  indicator: { arc_color: 0x5AA9E6, arc_width: 24 }
              - label: { x: 36, y: 172, width: 330, text_align: CENTER, text: "Impostato", text_font: f_s15, styles: st_mut }
              - label: { id: fr_set, x: 36, y: 196, width: 330, text_align: CENTER, text: "--", text_font: f_b76, styles: st_txt }
              - label: { id: fr_now, x: 36, y: 290, width: 330, text_align: CENTER, text: "", text_font: f_s15, styles: st_mut }
              - button:
                  <<: &pm { y: 440, width: 173, height: 64, styles: st_tile }
                  x: 20
                  widgets: [label: { align: CENTER, text: "-", text_font: f_b36 }]
                  on_click:
                    - homeassistant.service:
                        service: climate.set_temperature
                        data:
                          entity_id: climate.vevor_c50_fridge
                          temperature: !lambda 'return ui::fmt(std::fmax(-20.0f, id(frigo_target) - 1.0f), 0);'
              - button:
                  <<: *pm
                  x: 209
                  widgets: [label: { align: CENTER, text: "+", text_font: f_b36 }]
                  on_click:
                    - homeassistant.service:
                        service: climate.set_temperature
                        data:
                          entity_id: climate.vevor_c50_fridge
                          temperature: !lambda 'return ui::fmt(std::fmin(20.0f, id(frigo_target) + 1.0f), 0);'
              - button:
                  <<: &mode { y: 604, width: 112, height: 64, styles: st_tile, checked: { styles: st_modeon } }
                  id: fr_eco
                  x: 20
                  widgets:
                    - label: { align: CENTER, x: -20, text: "\U000F032A", text_font: i_s }
                    - label: { align: CENTER, x: 16, text: "Eco", text_font: f_s15 }
                  on_click:
                    - homeassistant.service: { service: climate.set_preset_mode, data: { entity_id: climate.vevor_c50_fridge, preset_mode: eco } }
              - button:
                  <<: *mode
                  id: fr_boost
                  x: 145
                  widgets:
                    - label: { align: CENTER, x: -24, text: "\U000F14DF", text_font: i_s }
                    - label: { align: CENTER, x: 14, text: "Boost", text_font: f_s15 }
                  on_click:
                    - homeassistant.service: { service: climate.set_preset_mode, data: { entity_id: climate.vevor_c50_fridge, preset_mode: boost } }
              - button:
                  <<: *mode
                  id: fr_onoff
                  x: 270
                  widgets:
                    - label: { align: CENTER, x: -30, text: "\U000F0425", text_font: i_s }
                    - label: { id: fr_onoff_l, align: CENTER, x: 12, text: "--", text_font: f_s15 }
                  on_click:
                    - if:
                        condition:
                          lambda: 'return id(ha_frigo_state).state == "off";'
                        then:
                          - homeassistant.service: { service: climate.turn_on, data: { entity_id: climate.vevor_c50_fridge } }
                        else:
                          - homeassistant.service: { service: climate.turn_off, data: { entity_id: climate.vevor_c50_fridge } }

        # ── Air conditioner (Dometic via IR, only with 230V) ──
        - obj:
            x: 542
            y: 96
            width: 402
            height: 688
            styles: st_card
            scrollable: false
            widgets:
              - label: { x: 20, y: 18, text: "\U000F001B", text_font: i_s, text_color: 0xE8845C }
              - label: { x: 52, y: 22, text: "CONDIZIONATORE", text_font: f_h15, styles: st_mut, text_letter_space: 2 }
              - label: { id: ac_avail, x: 250, y: 20, width: 132, text_align: RIGHT, text: "--", styles: st_mut }
              - arc:
                  <<: *dial
                  id: ac_arc
                  min_value: 18
                  max_value: 30
                  value: 25
                  indicator: { arc_color: 0x5A606A, arc_width: 24 }
              - label: { id: ac_mode_l, x: 36, y: 172, width: 330, text_align: CENTER, text: "--", text_font: f_s15, styles: st_mut }
              - label: { id: ac_set, x: 36, y: 196, width: 330, text_align: CENTER, text: "--", text_font: f_b76, styles: st_txt }
              - label: { id: ac_now, x: 36, y: 290, width: 330, text_align: CENTER, text: "", text_font: f_s15, styles: st_mut }
              - button:
                  <<: *pm
                  x: 20
                  widgets: [label: { align: CENTER, text: "-", text_font: f_b36 }]
                  on_click:
                    - homeassistant.service:
                        service: climate.set_temperature
                        data:
                          entity_id: climate.climatizzatore_camper
                          temperature: !lambda 'return ui::fmt(std::fmax(18.0f, id(clima_target) - 1.0f), 0);'
              - button:
                  <<: *pm
                  x: 209
                  widgets: [label: { align: CENTER, text: "+", text_font: f_b36 }]
                  on_click:
                    - homeassistant.service:
                        service: climate.set_temperature
                        data:
                          entity_id: climate.climatizzatore_camper
                          temperature: !lambda 'return ui::fmt(std::fmin(30.0f, id(clima_target) + 1.0f), 0);'
              - button:
                  <<: *mode
                  id: ac_cool
                  x: 20
                  widgets:
                    - label: { align: CENTER, x: -36, text: "\U000F0717", text_font: i_s }
                    - label: { align: CENTER, x: 12, text: "Auto", text_font: f_s15 }
                  on_click:
                    - homeassistant.service: { service: climate.set_hvac_mode, data: { entity_id: climate.climatizzatore_camper, hvac_mode: cool } }
              # manual: thermostat off first (it would switch the AC off below target), then the IR switch on
              - button:
                  <<: *mode
                  id: ac_man
                  x: 145
                  widgets:
                    - label: { align: CENTER, x: -36, text: "\U000F0210", text_font: i_s }
                    - label: { align: CENTER, x: 12, text: "Manuale", text_font: f_s15 }
                  on_click:
                    - homeassistant.service: { service: climate.set_hvac_mode, data: { entity_id: climate.climatizzatore_camper, hvac_mode: "off" } }
                    - homeassistant.service: { service: switch.turn_on, data: { entity_id: switch.climatizzatore } }
              - button:
                  <<: *mode
                  id: ac_off
                  x: 270
                  widgets:
                    - label: { align: CENTER, x: -30, text: "\U000F0425", text_font: i_s }
                    - label: { align: CENTER, x: 12, text: "Spegni", text_font: f_s15 }
                  on_click:
                    - homeassistant.service: { service: climate.set_hvac_mode, data: { entity_id: climate.climatizzatore_camper, hvac_mode: "off" } }
                    - homeassistant.service: { service: switch.turn_off, data: { entity_id: switch.climatizzatore } }

        # ── Webasto: status from HA (dedicated Webasto ESP32) ──
        - obj:
            x: 960
            y: 96
            width: 300
            height: 300
            styles: st_card
            scrollable: false
            widgets:
              - label: { x: 20, y: 18, text: "\U000F0238", text_font: i_s, text_color: 0xFF5A4E }
              - label: { x: 52, y: 22, text: "WEBASTO", text_font: f_h15, styles: st_mut, text_letter_space: 2 }
              - label: { id: lbl_webasto, x: 20, y: 66, text: "--", text_font: f_b26, styles: st_txt }
              - label: { x: 20, y: 108, width: 260, text: "Comando e stato arriveranno dal modulo Webasto dedicato.", text_font: f_s15, styles: st_mut, long_mode: WRAP }
              - obj: { x: 20, y: 222, width: 80, height: 56, radius: 16, styles: [st_tile, st_dim], clickable: false, widgets: [label: { align: CENTER, text: "30'", text_font: f_b20 }] }
              - obj: { x: 110, y: 222, width: 80, height: 56, radius: 16, styles: [st_tile, st_dim], clickable: false, widgets: [label: { align: CENTER, text: "1 h", text_font: f_b20 }] }
              - obj: { x: 200, y: 222, width: 80, height: 56, radius: 16, styles: [st_tile, st_dim], clickable: false, widgets: [label: { align: CENTER, text: "\U000F0425", text_font: i_s }] }

        # ── Room temperatures ──
        - obj:
            x: 960
            y: 412
            width: 300
            height: 372
            styles: st_card
            scrollable: false
            widgets:
              - label: { x: 20, y: 18, text: "\U000F0F55", text_font: i_s, text_color: 0xE8845C }
              - label: { x: 52, y: 22, text: "AMBIENTI", text_font: f_h15, styles: st_mut, text_letter_space: 2 }
              - label: { x: 20, y: 76, text: "Dinette", styles: st_mut }
              - label: { id: am_din, x: 140, y: 70, width: 140, text_align: RIGHT, text: "--", text_font: f_b26, styles: st_txt }
              - obj: { x: 20, y: 114, width: 260, height: 1, styles: st_sep, clickable: false }
              - label: { x: 20, y: 136, text: "Mansarda", styles: st_mut }
              - label: { id: am_mans, x: 140, y: 130, width: 140, text_align: RIGHT, text: "--", text_font: f_b26, styles: st_txt }
              - obj: { x: 20, y: 174, width: 260, height: 1, styles: st_sep, clickable: false }
              - label: { x: 20, y: 196, text: "Letto", styles: st_mut }
              - label: { id: am_letto, x: 140, y: 190, width: 140, text_align: RIGHT, text: "--", text_font: f_b26, styles: st_txt }
              - obj: { x: 20, y: 234, width: 260, height: 1, styles: st_sep, clickable: false }
              - label: { x: 20, y: 256, text: "Nel frigo", styles: st_mut }
              - label: { id: am_frigo, x: 140, y: 250, width: 140, text_align: RIGHT, text: "--", text_font: f_b26, styles: st_txt }
              - obj: { x: 20, y: 294, width: 260, height: 1, styles: st_sep, clickable: false }
              - label: { x: 20, y: 316, text: "Esterna", styles: st_mut }
              - label: { id: am_ext, x: 140, y: 310, width: 140, text_align: RIGHT, text: "--", text_font: f_b26, styles: st_txt }

    # ═══════════════ VEHICLE (secondary: the Atoto is the main vehicle display) ═══════════════
    - id: page_veicolo
      styles: st_page
      widgets:
        - obj:
            x: 124
            y: 96
            width: 340
            height: 476
            styles: st_card
            scrollable: false
            widgets:
              - label: { x: 20, y: 18, text: "\U000F07FB", text_font: i_s, text_color: 0xE8845C }
              - label: { x: 52, y: 22, text: "VEICOLO", text_font: f_h15, styles: st_mut, text_letter_space: 2 }
              - label: { id: vs_ico, x: 20, y: 62, text: "\U000F0A47", text_font: i_l, styles: st_dim }
              - label: { id: vs_state, x: 78, y: 64, text: "--", text_font: f_b26, styles: st_txt }
              - label: { id: vs_sub, x: 78, y: 98, width: 250, text: "", text_font: f_s15, styles: st_mut }
              - label: { x: 20, y: 152, text: "Gasolio", text_font: f_s15, styles: st_mut }
              - label: { id: vs_fuel, x: 20, y: 172, text: "--", text_font: f_b36, styles: st_txt }
              - label: { id: vs_fuel_km, x: 150, y: 184, width: 170, text_align: RIGHT, text: "", text_font: f_b20, styles: st_txt }
              - bar: { id: vs_fuel_bar, x: 20, y: 224, width: 300, height: 10, value: 0, styles: st_track, radius: 5, indicator: { bg_color: 0xF0A500, radius: 5 } }
              - label: { x: 20, y: 262, text: "Olio motore", styles: st_mut }
              - label: { id: vs_oil, x: 170, y: 261, width: 150, text_align: RIGHT, text: "--", text_font: f_b20, styles: st_txt }
              - obj: { x: 20, y: 298, width: 300, height: 1, styles: st_sep, clickable: false }
              - label: { x: 20, y: 316, text: "Liquido", styles: st_mut }
              - label: { id: vs_cool, x: 170, y: 315, width: 150, text_align: RIGHT, text: "--", text_font: f_b20, styles: st_txt }
              - obj: { x: 20, y: 352, width: 300, height: 1, styles: st_sep, clickable: false }
              - label: { x: 20, y: 370, text: "Batteria motore", styles: st_mut }
              - label: { id: vs_v1, x: 170, y: 369, width: 150, text_align: RIGHT, text: "--", text_font: f_b20, styles: st_txt }
              - obj: { x: 20, y: 406, width: 300, height: 1, styles: st_sep, clickable: false }
              - label: { x: 20, y: 424, text: "Km totali", styles: st_mut }
              - label: { id: vs_km, x: 170, y: 423, width: 150, text_align: RIGHT, text: "--", text_font: f_b20, styles: st_txt }

        # ── Tyres (nose to the right: left side at the top) ──
        - obj:
            x: 480
            y: 96
            width: 440
            height: 476
            styles: st_card
            scrollable: false
            widgets:
              - label: { id: ty_head_i, x: 20, y: 18, text: "\U000F0C4D", text_font: i_s, text_color: 0x8A909A }
              - label: { x: 52, y: 22, text: "GOMME", text_font: f_h15, styles: st_mut, text_letter_space: 2 }
              - label: { id: ty_head, x: 220, y: 20, width: 200, text_align: RIGHT, text: "--", styles: st_mut }
              - image: { x: 55, y: 176, src: img_roof }
              - label: { id: ty_ps, x: 20, y: 72, text: "--", text_font: f_b26, text_color: 0x8A909A }
              - label: { id: ty_ps_t, x: 20, y: 106, text: "", text_font: f_s15, styles: st_mut }
              - label: { id: ty_as, x: 240, y: 72, width: 180, text_align: RIGHT, text: "--", text_font: f_b26, text_color: 0x8A909A }
              - label: { id: ty_as_t, x: 240, y: 106, width: 180, text_align: RIGHT, text: "", text_font: f_s15, styles: st_mut }
              - label: { id: ty_pd, x: 20, y: 348, text: "--", text_font: f_b26, text_color: 0x8A909A }
              - label: { id: ty_pd_t, x: 20, y: 382, text: "", text_font: f_s15, styles: st_mut }
              - label: { id: ty_ad, x: 240, y: 348, width: 180, text_align: RIGHT, text: "--", text_font: f_b26, text_color: 0x8A909A }
              - label: { id: ty_ad_t, x: 240, y: 382, width: 180, text_align: RIGHT, text: "", text_font: f_s15, styles: st_mut }
              - label: { x: 20, y: 440, width: 400, text_align: CENTER, text: "muso a destra · soglie della vista Gomme", text_font: f_s14, styles: st_dim }

        # ── Level ──
        - obj:
            x: 936
            y: 96
            width: 324
            height: 476
            styles: st_card
            scrollable: false
            widgets:
              - label: { x: 20, y: 18, text: "\U000F14F1", text_font: i_s, text_color: 0xE8845C }
              - label: { x: 52, y: 22, text: "LIVELLA", text_font: f_h15, styles: st_mut, text_letter_space: 2 }
              - obj:
                  x: 42
                  y: 76
                  width: 240
                  height: 240
                  radius: 120
                  styles: st_tile
                  scrollable: false
                  clickable: false
                  widgets:
                    - obj: { x: 40, y: 40, width: 160, height: 160, radius: 80, styles: st_ring, clickable: false }
                    - obj: { x: 80, y: 80, width: 80, height: 80, radius: 40, styles: st_ring, clickable: false }
                    - obj: { x: 0, y: 119, width: 240, height: 2, styles: st_sep, clickable: false }
                    - obj: { x: 119, y: 0, width: 2, height: 240, styles: st_sep, clickable: false }
                    - obj: { id: lv_dot, x: 98, y: 98, width: 44, height: 44, radius: 22, bg_color: 0x8A909A, bg_opa: 90%, border_width: 0, clickable: false }
              - label: { id: lv_state, x: 20, y: 340, width: 284, text_align: CENTER, text: "--", text_font: f_b20, styles: st_txt }
              - label: { id: lv_xy, x: 20, y: 372, width: 284, text_align: CENTER, text: "", text_font: f_s15, styles: st_mut }
              - label: { x: 20, y: 420, width: 284, text_align: CENTER, text: "bolla al centro = in piano", text_font: f_s14, styles: st_dim }

        # ── Last trip (dashboard TRIP via CAN) ──
        - obj:
            x: 124
            y: 588
            width: 540
            height: 196
            styles: st_card
            scrollable: false
            widgets:
              - label: { x: 20, y: 18, text: "\U000F08F0", text_font: i_s, text_color: 0xE8845C }
              - label: { x: 52, y: 22, text: "ULTIMO VIAGGIO", text_font: f_h15, styles: st_mut, text_letter_space: 2 }
              - obj: { <<: &trip { y: 96, width: 117, height: 80, styles: st_tile, scrollable: false, clickable: false }, x: 20, widgets: [label: { x: 14, y: 12, text: "Distanza", text_font: f_s15, styles: st_mut }, label: { id: tr_dist, x: 14, y: 40, text: "--", text_font: f_b20 }] }
              - obj: { <<: *trip, x: 149, widgets: [label: { x: 14, y: 12, text: "Durata", text_font: f_s15, styles: st_mut }, label: { id: tr_dur, x: 14, y: 40, text: "--", text_font: f_b20 }] }
              - obj: { <<: *trip, x: 278, widgets: [label: { x: 14, y: 12, text: "Media", text_font: f_s15, styles: st_mut }, label: { id: tr_avg, x: 14, y: 40, text: "--", text_font: f_b20 }] }
              - obj: { <<: *trip, x: 407, widgets: [label: { x: 14, y: 12, text: "L/100 km", text_font: f_s15, styles: st_mut }, label: { id: tr_cons, x: 14, y: 40, text: "--", text_font: f_b20 }] }
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
