danderik88/cbe-ds300-esphome-panel/(commit log)

2026-10-14 Initial public release: DS-300 conn 17 pinout, interface wiring, ESP32-P4 ESPHome panel firmware, printed plug and mount
    Claude-Session: https://claude.ai/code/session_0126Dvc4Eq6tF5DjYDn9BQES
    [assieme.step, piastra_display.step, piastra_display.stl, spina_idc16.step, spina_idc16.stl, staffa_parete.step, staffa_parete.stl]
2026-10-14 docs: English everywhere outside the on-screen UI (diagrams, file names, photo labels, secrets key)
    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
    [assembly.step, display_plate.step, display_plate.stl, idc16_plug.step, idc16_plug.stl, wall_bracket.step, wall_bracket.stl]
2026-10-15 docs: frame the repo as a shared reference build and explain how the pinout was found
    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
2026-10-16 docs: explain the Italian CBE pin labels, same on the UK edition
    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
2026-10-16 docs: full wiring drawings (overview, probes, perfboard layout, cable list, pictorial) in English
    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
2026-10-19 docs: original panel is a CBE PC220-family board with a custom Elnagh front
    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
